ignacio82/grav-mass/bom/bom.csv

section | id | qty | sku | name | vendor | url | alt_skus | spec | where_used | category | optional | notes
electronics | psu-12v-5a | 1 | B01D8FLSV8 | BTF-LIGHTING Regulated `12V DC 5A (60W)` Power Supply Adapter | Amazon | https://www.amazon.com/dp/B01D8FLSV8 |  | `100–240V AC` in → Regulated `12.0V DC, 5.0A (60W)` out, `5.5 × 2.1 mm` center-positive plug, AC wall cord included | Single external power cord plugging into the rear `-X` `5.5 × 2.1 mm` DC barrel jack on [`trunk_base`](../cad/trunk.py) (`26.5W` max simultaneous peak load) | power | false | status: **Required *(New — Single External Supply)*** | link_text: Amazon — BTF-LIGHTING `12V 5A 60W` Power Supply Adapter (`B01D8FLSV8`)
electronics | dc-barrel-jack | 1 | B07C7VSRBG | Pre-Wired `5.5 × 2.1 mm` Threaded Panel-Mount DC Barrel Jack (`18 AWG` Leads) | Amazon | https://www.amazon.com/dp/B07C7VSRBG |  | `12–24V DC`, `5A–10A` rated, `M11 × 0.75` (`Ø 11.0 mm`) thread with hex nut & pre-attached `18 AWG` red/black leads | Mounts into the **`Ø 11.4 mm` rear `-X` DC jack port** (`Z = 10.0 mm`) on [`trunk_base`](../cad/trunk.py); pigtails route internally into the Hollow Root Vault | power | false | status: **Required *(New — Panel DC Entry)*** | link_text: Amazon — 5.5 × 2.1 mm Threaded Panel-Mount DC Barrel Jack with Pre-Wired 18 AWG Leads (`B07C7VSRBG`)
electronics | buck-12v-to-5v | 1 | B07XXWQ49N | UCTRONICS `DC 9V–36V to 5.0V 5A (25W)` Buck Converter Module with Screw Terminals (`U6223`) | Amazon | https://www.amazon.com/UCTRONICS-Converter-Transformer-Voltage-Regulator/dp/B07XXWQ49N | U6223 | `9–36V DC` in → Fixed **`5.0V DC, 5.0A (25W)`** out (`63.0 × 27.0 × 10.0 mm`) with onboard `VIN+/GND` and `OUT+/GND` screw terminals | Seats into the dedicated `+Y` snap-in cradle (`64.2 × 28.2 × 12.0 mm`) inside the `Ø 135 × 50 mm` Hollow Root Vault on Branch 2 (`F2 = 3A` fuse) to power all 66 WS2812B LEDs without loading `C008`'s USB diode | power | false | status: **Required *(New — 5V LED Rail)*** | link_text: Amazon — UCTRONICS `DC 9V–36V to 5V 5A` Screw-Terminal Buck Converter (`B07XXWQ49N`)
electronics | wago-221-pack | 1 | B07NKT2P2F | WAGO `221` Lever-Nut 15-Piece Assortment Pocket Pack (`221-412`, `221-413`, `221-415`) | Amazon | https://www.amazon.com/dp/B07NKT2P2F | 221-412;221-413;221-415 | Includes `5× 221-415` (5-port, `30.0 × 18.6 × 8.4 mm`), `5× 221-413` (3-port, `18.7 × 18.6 × 8.4 mm`), and `5× 221-412` (2-port, `13.1 × 18.6 × 8.4 mm`) lever connectors (`24–12 AWG`) | Uses `2× 221-415` (`WAGO-1 +12V` & `WAGO-2 Star GND`, seated in the `+X` `19.8 × 31.2 × 18.0 mm` organizer cradle) + `2× 221-413` (`WAGO-3 +5V LED` & `WAGO-4 LED GND`) for 100% tool-free distribution | power-distribution | false | qty_display: **1× Pack** | status: **Required *(New — Solder-Free Bus)*** | link_text: Amazon — WAGO `221` Lever-Nut 15-Piece Assortment Pocket Pack (`B07NKT2P2F`)
electronics | inline-blade-fuses | 1 | B087BT1PH3 | Bst4U 6-Pack Inline Blade Fuse Holders + 100-Piece Blade Fuse Assortment Kit (`2A, 3A, 5A` Included) | Amazon | https://www.amazon.com/dp/B087BT1PH3 |  | `6×` pre-wired inline blade fuse holders with protective caps + `100×` blade fuses (`2A, 3A, 5A, 7.5A, 10A, 15A, 20A, 25A, 30A, 35A`) | Uses `3×` inline fuse holders inside the Hollow Root Vault: **`F0 = 5A`** (main `12V` input), **`F1 = 2A`** (`A092` controller/motor), and **`F2 = 3A`** (`5V` LED buck) | protection | false | qty_display: **1× Kit** | status: **Required *(New — Branch Fuses)*** | link_text: Amazon — Bst4U 6-Pack Inline Blade Fuse Holders + 100pc Fuse Kit (`B087BT1PH3`)
electronics | bulk-cap-1000uf | 1 | B07WPWFSNQ | BOJACK `1000 µF 16V` `105 °C` Radial Electrolytic Capacitors (10-Pack) | Amazon | https://www.amazon.com/dp/B07WPWFSNQ |  | `1000 µF`, `16V DC`, `105 °C` low-ESR radial aluminum electrolytic capacitor (`Ø 10 × 17 mm`) | **1×** capacitor has its `+` and `-` leads clamped directly into the `OUT+` and `GND` screw terminals of the `B07XXWQ49N` `5V` buck converter | power | false | qty_display: **1× Pack** | status: **Required *(New — 5V Bulk Cap)*** | link_text: Amazon — BOJACK `1000 µF 16V 105°C` Radial Electrolytic Capacitors (`B07WPWFSNQ`)
electronics | m5stack-hdriver-base | 1 | A092 | M5Stack Atomic H-Bridge Driver Base (`DRV8876`) | M5Stack Store | https://shop.m5stack.com/products/atomic-h-bridge-driver-base-drv8876 |  | `48.0 × 24.0 × 18.0 mm`, **`9–24V DC` input**, TI `DRV8876` H-Bridge (`1.5A` cont / `2.0A` peak), internal `MP1584EN` `12V→5V` buck for `C008`, `HT3.96-4P` screw terminals (`M1`, `M2`, `VIN`, `GND`) | Seats into the stepped `-Y` bottom ESPHome bay (`49.2 × 25.2 × 20.3 mm`) of [`trunk_base`](../cad/trunk.py); powered by **`12.0V DC`** on `VIN`/`GND` via Fuse `F1 (2A)` | controller | false | status: **Existing *(Retained)*** | link_text: M5Stack Store — Atomic H-Bridge Driver Base (`A092`)
electronics | m5stack-atom-lite | 1 | C008 | M5Stack ATOM Lite ESP32 Development Kit | M5Stack Store | https://shop.m5stack.com/products/atom-lite-esp32-development-kit |  | `24.0 × 24.0 × 9.5 mm` `ESP32-PICO-D4` Wi-Fi/BLE controller with `HY2.0-4P` Grove port, `SK6812` RGB LED & button | Snaps onto `A092` (powered internally from `A092`'s `12V→5V` regulator; USB-C needed only for initial flashing of [`esphome/grav-mass-tree.yaml`](../esphome/grav-mass-tree.yaml)) | controller | false | status: **Existing *(Retained)*** | link_text: M5Stack Store — ATOM Lite ESP32 (`C008`)
electronics | m5stack-grove2dupont | 1 | A096 | M5Stack Grove2Dupont Conversion Cable (`20 cm, 5 Pairs`) | M5Stack Store | https://shop.m5stack.com/products/grove2dupont-conversion-cable-20cm-5pairs |  | Male `HY2.0-4P` Grove plug to 4× 2.54 mm DuPont pins (`Black=GND`, `White=G26`, `Yellow=G32`, `Red=+5V` capped/isolated) | Plugs into `C008` Grove port to carry **`White = GPIO26` Track Data**, **`Yellow = GPIO32` Topper Data**, and **`Black = Signal GND`** (`Red +5V` is capped to prevent backfeeding!) | wiring | false | status: **Existing *(Retained)*** | link_text: M5Stack Store — Grove2Dupont Conversion Cable (`A096`)
electronics | motor-n20-12v-150rpm | 1 | B0BFRPMSW6 | `12V DC 150 RPM N20` Micro Metal Gear Motor (`Ø 3.0 mm` D-Shaft) | Amazon | https://www.amazon.com/dp/B0BFRPMSW6 | LA002 | `10 × 12 × 25 mm` metal gearbox (100% identical size to `LA002`), **`12.0V DC` rated**, `150 RPM`, `0.90 kg·cm` torque, `Ø 3.0 mm` D-shaft | Drops directly into [`trunk_base`](../cad/trunk.py) & [`Servo_Or_030_Adapter`](../cad/auger.py) and clamps straight into `A092` **`M1` & `M2`** (`12V` native PWM)! | motor | false | status: **Required *(New — 12V Auger Motor)*** | link_text: Amazon — `12V DC 150 RPM N20` Micro Metal Gear Motor, `Ø 3mm` D-Shaft (`B0BFRPMSW6`)
electronics | led-track-pebble-ws2812b | 1 | B0CCS11V7H | BTF-LIGHTING `DC5V` Addressable `WS2812B` RGB Pebble / Seed Pixel Flexible Wire (`16.4ft / 50 LEDs`, Track) | Amazon | https://www.amazon.com/dp/B0CCS11V7H |  | `360°`-flexible 3-wire cord with `50×` `6.2 × 3.2 mm` oval epoxy RGB LED drops (`5V`, `5W` nominal / `9W` max white), 3-pin `JST-SM` + start/end power-injection leads | Snaps into the **`8.0 × 3.6 mm` dovetail channel (`4.6 mm` throat)** under [`track_seg_01`](../cad/track.py)..[`14`](../cad/track.py); powered from `5V` Buck (`WAGO-3/4`), Data from **`GPIO26` (White)** | lighting-wired | false | status: **Existing *(Retained)*** | link_text: Amazon — BTF-LIGHTING `DC5V` `WS2812B` Pebble/Seed Pixel Flexible Wire (`B0CCS11V7H`)
electronics | led-topper-ring-ws2812 | 1 | B09YTMNGTD | Sparkleiot 16-Bit WS2812 RGB LED Ring with `SM2.54-3P` Wire (Apple Topper) | Amazon | https://www.amazon.com/dp/B09YTMNGTD |  | `Ø 45.0 mm` OD × `Ø 32.0 mm` ID addressable 16-LED 5V RGB ring (`4.8W` max white) with pre-wired 3-pin `JST-SM` (`SM2.54-3P`) plug | Seats flat in the **`Ø 46.2 × 2.5 mm` top rim recess** of [`trunk_top`](../cad/trunk.py) (`Z = 447.5 mm`) inside [`golden_apple_topper`](../cad/topper_planets.py); powered from `5V` Buck, Data from **`GPIO32` (Yellow)** | lighting-wired | false | status: **Existing *(Retained)*** | link_text: Amazon — Sparkleiot 16-Bit WS2812 RGB LED Ring (`B09YTMNGTD`)
electronics | jst-sm-3pin-ext-1m | 1 | B0CT827QQC | 3-Pin `JST-SM` (`SM2.54-3P`) Male-to-Female Extension Cable (`1 m`) | Amazon | https://www.amazon.com/dp/B0CT827QQC |  | 3-pin `JST-SM` plug-and-play extension wire (`5V`, `GND`, `DATA`) | Plugs into the Sparkleiot Topper Ring (`zero soldering`), threads down the **`10 × 8 mm` rear `-X` trunk conduit**, and connects to `WAGO-3/4` (`5V`/`GND`) + **`GPIO32` (Yellow)** | wiring | false | status: **Existing *(Retained)*** | link_text: Amazon — BTF-LIGHTING 3-Pin JST-SM Extension Cable (`B0CT827QQC`)
electronics | led-marble-y-shape | 6 | KC013 | Bambu Lab Y-Shape LED Light with Magnetic Control Switch — Warm White (6 Rolling Apple Marbles) | Bambu Lab Store | https://us.store.bambulab.com/products/y-shape-led-light-with-magnetic-control-switch | KC012 | `Ø 18.0 × 6.5 mm` 3-LED Y-board (`CR1632` battery + `Ø 8 × 2 mm` magnet included) | **6×** drop into the **`Ø 18.70 × 7.30 mm`** equatorial chamber of the 6 Quarter-Turn Bayonet Twist-Lock Marbles (`Apple_Hemisphere_A` + `B`) | lighting-wireless | false | status: **Existing *(Retained)*** | link_text: Bambu Lab Store — Y-Shape LED Light with Magnetic Control Switch (`KC013`)
electronics | led-planet-single | 8 | KA006 | Bambu Lab Single LED Magnetic Control Switch Light (8 Solar System Planets) | Bambu Lab Store | https://us.store.bambulab.com/products/single-led-magnetic-control-switch-light |  | `Ø 7.5 × 6.0 mm` single-LED (`CR927` battery + `Ø 8 × 2 mm` magnet included) | **8×** press-fit into the `Ø 8.0 × 10.0 mm` bottom bores of the 8 Solar System planets (`planet_mercury..neptune`); **1×** magnet presses into [`Magic_LED_Wand`](../cad/topper_planets.py) | lighting-wireless | false | status: **Existing *(Retained)*** | link_text: Bambu Lab Store — Single LED Magnetic Control Switch Light (`KA006`)
electronics | m5stack-ina226-sensor | 1 | U190 | M5Stack Unit `INA226-10A` High-Precision Current/Voltage/Power Sensor | M5Stack Store | https://shop.m5stack.com/products/ina226-voltage-and-current-measurement-unit-10a |  | `32.0 × 24.0 × 10.2 mm`, `0–30V DC`, `±10A`, `HT3.96-4P` screw terminals + Grove `HY2.0-4P` I2C (`0x41`) | Clamps inline with the `5V` LED buck output (`GPIO21`/`GPIO25` I2C header) for real hardware current/power measurement in ESPHome | telemetry | true | qty_display: *Optional* | status: *Optional Telemetry* | link_text: M5Stack Store — Unit `INA226-10A` (`U190`)
electronics | coin-cell-cr1632 | 1 | B07V5CW1MG | LiCB `CR1632` 3V Lithium Coin Cell Batteries (5-Pack) | Amazon | https://www.amazon.com/dp/B07V5CW1MG | CR1632 | `CR1632` (`Ø 16.0 × 3.2 mm`, `3V`) for `KC013` Y-Shape Marble LEDs | Spare coin-cell batteries for the 6 wireless glowing marbles (`KC013`) | battery | true | qty_display: *Optional* | status: *Spare Marble Cells* | link_text: Amazon — LiCB `CR1632` 3V Lithium Coin Cells, 5-Pack (`B07V5CW1MG`)
electronics | coin-cell-cr927 | 1 | B0CMCFGXSL | Tenergy `CR927` 3V Lithium Button Cell Batteries | Amazon | https://www.amazon.com/dp/B0CMCFGXSL | CR927 | `CR927` (`Ø 9.5 × 2.7 mm`, `3V`) for `KA006` Planet LEDs | Spare coin-cell batteries for the 8 wireless Solar System planets (`KA006`) | battery | true | qty_display: *Optional* | status: *Spare Planet Cells* | link_text: Amazon — Tenergy `CR927` 3V Lithium Button Cells (`B0CMCFGXSL`)
fasteners | screw-m25x6-bhcs | 2 | B0BYF4X65F | MonsterBolts `M2.5 × 6 mm` Button Head Cap Machine Screws (BHCS) | Amazon | https://www.amazon.com/dp/B0BYF4X65F |  | `M2.5 × 6 mm` stainless steel button head machine screws | Secures [`Battery_Cover`](../output/Battery_Cover.stl) to the bottom of `trunk_base` | fastener | false | link_text: Amazon — MonsterBolts M2.5 × 6mm Button Head Screws, 50-Pack (`B0BYF4X65F`)
filament | filament-11801 | 2 | 11801 | PLA Matte Dark Brown (`11801`) (#4A2F1D) | Bambu Lab Store | https://us.store.bambulab.com/products/pla-matte |  | ~1150 g (2x 1 kg spools) | **Core Tree `T1`** *(Plates 1–4, 16, 17)* | filament | false
filament | filament-32501 | 2 | 32501 | PETG Translucent Teal (`32501`) (#00A86B) | Bambu Lab Store | https://us.store.bambulab.com/products/petg-translucent |  | ~1080 g (2x 1 kg spools) | **Core Tree `T2`** *(Plates 5–13, 16, 18)* | filament | false
filament | filament-13405 | 1 | 13405 | PLA Silk+ Gold (`13405`) (#D4AF37) | Bambu Lab Store | https://us.store.bambulab.com/products/pla-silk-upgrade |  | ~125 g (1x 1 kg spool) | **Core Tree `T3`** *(Plates 14, 16, 17, 18)* | filament | false
filament | filament-10200 | 1 | 10200 | PLA Basic Red (`10200`) (#C41E3A) | Bambu Lab Store | https://us.store.bambulab.com/products/pla-basic-filament |  | ~155 g (1x 1 kg spool) | **Core Tree `T4`** *(Plates 15, 16, 17)* | filament | false
filament | filament-11100 | 1 | 11100 | PLA Matte Ivory White (`11100`) (#F5EFE6) | Bambu Lab Store | https://us.store.bambulab.com/products/pla-matte |  | ~35 g (1x 1 kg spool) | **Planet Accent** *(Plate 17 `T2` & Plate 18 `T3`)* | filament | false
filament | filament-11600 | 1 | 11600 | PLA Matte Marine Blue (`11600`) (#1E5AA8) | Bambu Lab Store | https://us.store.bambulab.com/products/pla-matte |  | ~30 g (1x 1 kg spool) | **Ocean/Ice Planet Accent** *(Plate 18 `T1`)* | filament | false
