ignacio82/grav-mass/output/3mf/GravMass_Tree_Complete_Assembly.3mf

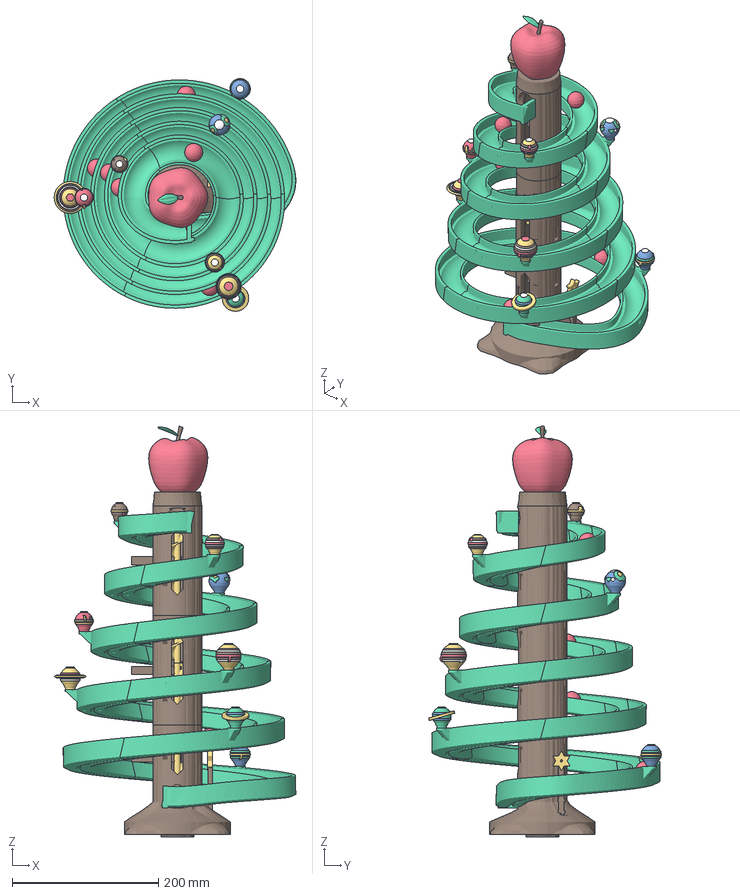
[picture p1: CAD file, 2026-11-08]
output/3mf/GravMass_Tree_Complete_Assembly.3mf
331.0 x 318.8 x 562.8 mm
asm_trunk_base
asm_trunk_mid
asm_trunk_top
asm_Base_Bottom_Cover
asm_Conduit_Cover_Strip_01
asm_Conduit_Cover_Strip_02
asm_Conduit_Cover_Strip_03
asm_auger_lower
asm_auger_upper
asm_track_seg_01
asm_track_seg_02
asm_track_seg_03
asm_track_seg_04
asm_track_seg_05
asm_track_seg_06
asm_track_seg_07
asm_track_seg_08
asm_track_seg_09
asm_track_seg_10
asm_track_seg_11
asm_track_seg_12
asm_track_seg_13
asm_track_seg_14
asm_golden_apple_topper_apple_red_shell
asm_golden_apple_topper_apple_brown_stem
asm_golden_apple_topper_apple_brown_trunk_collar_1
asm_golden_apple_topper_apple_green_leaf
asm_planet_mercury_mercury_basalt_core
asm_planet_mercury_mercury_gold_caloris_basin
asm_planet_mercury_mercury_terracotta_craters_4
asm_planet_mercury_mercury_terracotta_craters_3
asm_planet_mercury_mercury_terracotta_craters_2
asm_planet_mercury_mercury_terracotta_craters_1
asm_planet_mercury_mercury_alabaster_polar_crown
asm_planet_venus_venus_gold_cloud_deck
asm_planet_venus_venus_alabaster_y_waves_3
asm_planet_venus_venus_alabaster_y_waves_2
asm_planet_venus_venus_alabaster_y_waves_1
asm_planet_venus_venus_umber_vortex_collars_2
asm_planet_venus_venus_umber_vortex_collars_1
asm_planet_venus_venus_crimson_superrotation
asm_planet_earth_earth_cobalt_ocean_globe
asm_planet_earth_earth_emerald_continents
asm_planet_earth_earth_gold_mountain_ranges_2
asm_planet_earth_earth_gold_mountain_ranges_1
asm_planet_earth_earth_white_polar_ice_clouds_3
asm_planet_earth_earth_white_polar_ice_clouds_2
asm_planet_earth_earth_white_polar_ice_clouds_1
asm_planet_mars_mars_terracotta_body
asm_planet_mars_mars_ochre_tharsis_hellas
asm_planet_mars_mars_basalt_canyon_olympus_2
asm_planet_mars_mars_basalt_canyon_olympus_1
asm_planet_mars_mars_alabaster_polar_cap
asm_planet_jupiter_jupiter_gold_zones
asm_planet_jupiter_jupiter_alabaster_tropical_zones_2
asm_planet_jupiter_jupiter_alabaster_tropical_zones_1
asm_planet_jupiter_jupiter_umber_temperate_belts_3
asm_planet_jupiter_jupiter_umber_temperate_belts_2
asm_planet_jupiter_jupiter_umber_temperate_belts_1
asm_planet_jupiter_jupiter_crimson_great_red_spot_2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
