ignacio82/grav-mass/output/3mf/Plate_6_SingleColor_Green_Track_02.3mf

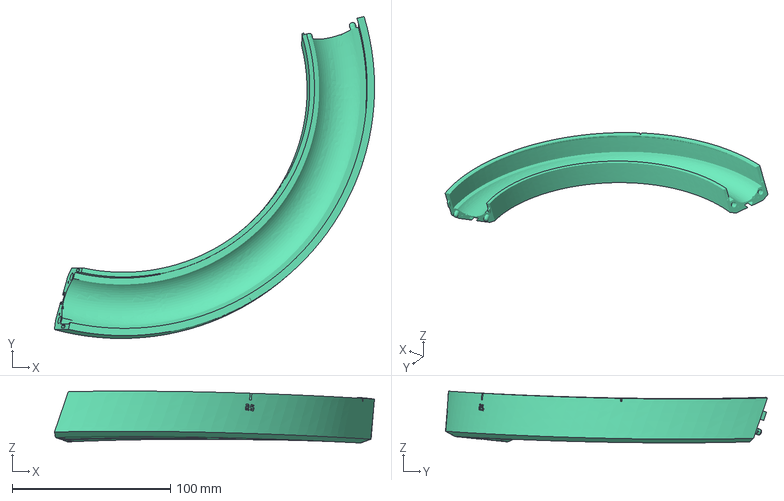
[picture p2: CAD file, 2026-11-08]
output/3mf/Plate_6_SingleColor_Green_Track_02.3mf
202.2 x 203.4 x 32.7 mm
