ignacio82/grav-mass/output/track_seg_13.step

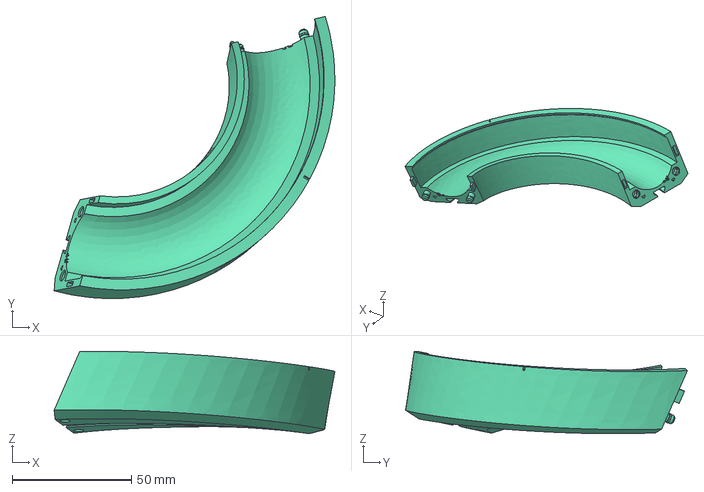
[picture p3: CAD file, 2026-11-08]
output/track_seg_13.step
117.9 x 118.4 x 34.6 mm
