ignacio82/grav-mass/output/3mf/Plate_13_SingleColor_Green_Track_09_And_14.3mf

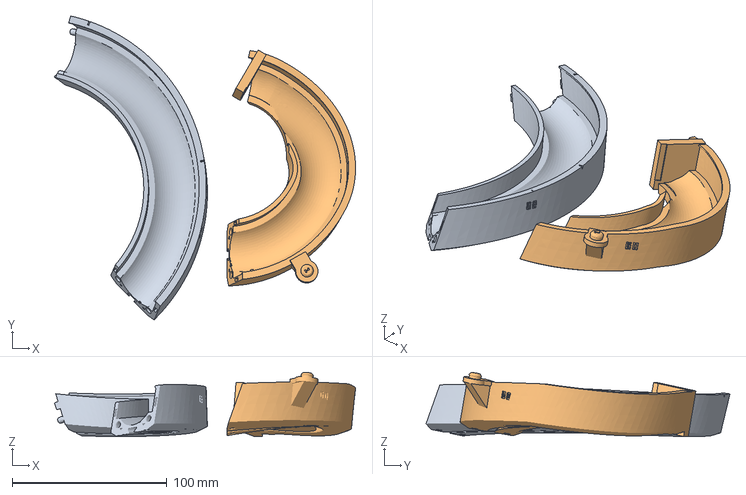
[picture p4: CAD file, 2026-11-08]
output/3mf/Plate_13_SingleColor_Green_Track_09_And_14.3mf
194.5 x 196.3 x 41.4 mm
track_seg_09
track_seg_14_top_entry
