ignacio82/grav-mass/output/bracket_19.step

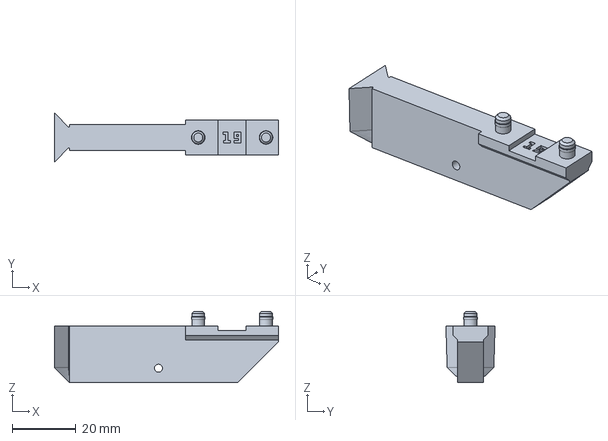
[picture p5: CAD file, 2026-11-08]
output/bracket_19.step
70.0 x 15.4 x 22.2 mm
