ignacio82/grav-mass/output/3mf/Plate_8_SingleColor_Green_Track_04.3mf

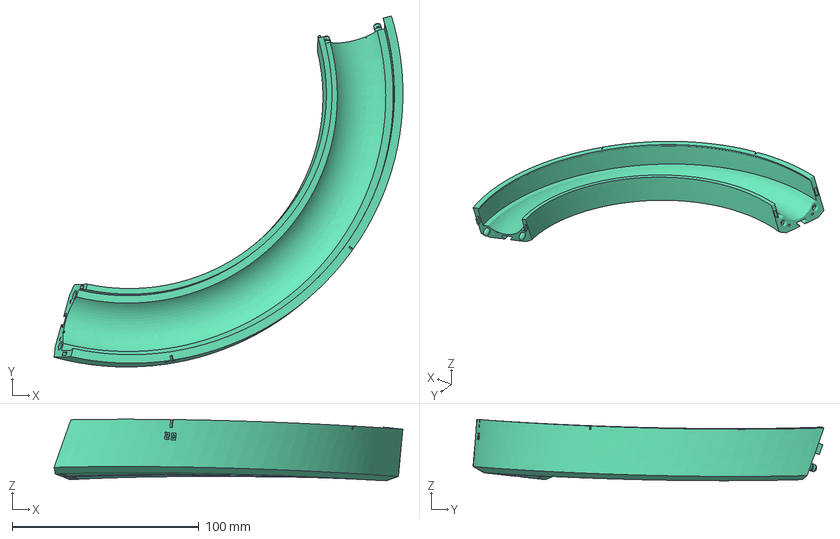
[picture p6: CAD file, 2026-11-08]
output/3mf/Plate_8_SingleColor_Green_Track_04.3mf
186.6 x 187.8 x 32.9 mm
