ignacio82/grav-mass/output/track_seg_12.step

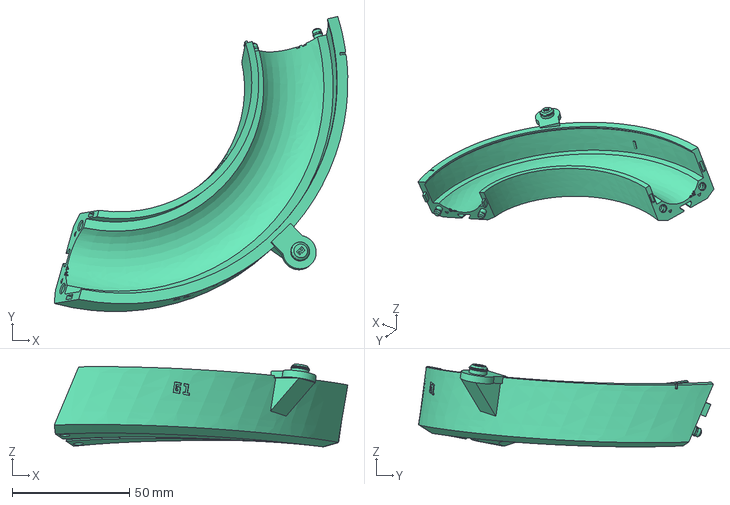
[picture p7: CAD file, 2026-11-08]
output/track_seg_12.step
125.3 x 125.9 x 35.4 mm
