ignacio82/grav-mass/output/planet_jupiter.step

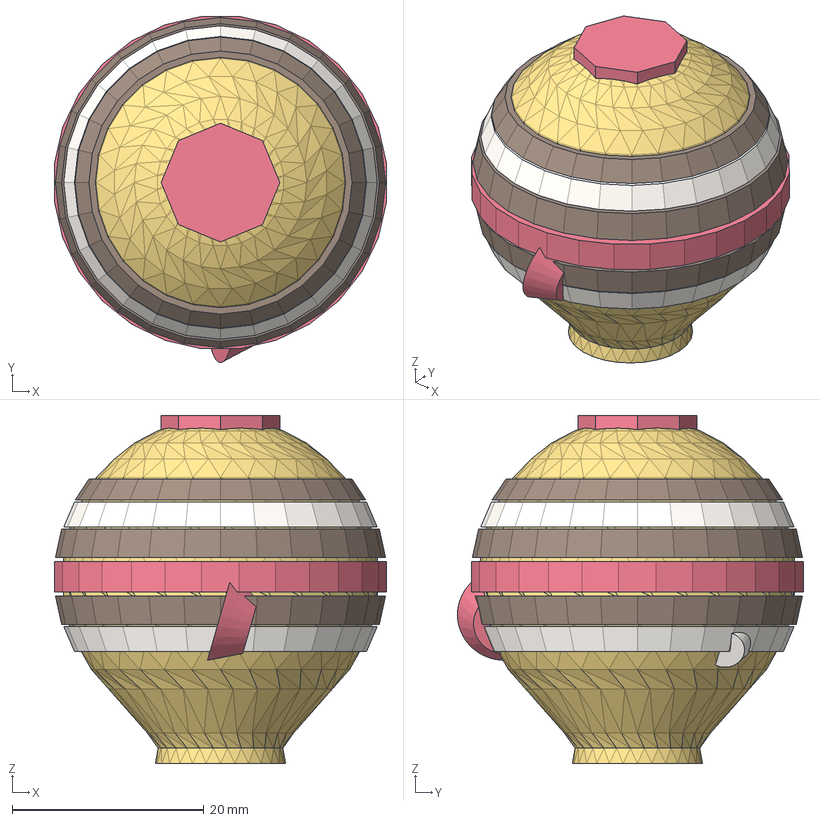
[picture p8: CAD file, 2026-11-08]
output/planet_jupiter.step
34.7 x 36.1 x 36.3 mm
jupiter_gold_zones
jupiter_alabaster_tropical_zones_2
jupiter_alabaster_tropical_zones_1
jupiter_umber_temperate_belts_3
jupiter_umber_temperate_belts_2
jupiter_umber_temperate_belts_1
jupiter_crimson_great_red_spot_2
jupiter_crimson_great_red_spot_1
