ignacio82/grav-mass/output/3mf/Plate_17_MultiColor_Planets_Warm_And_Gas_Giants.3mf

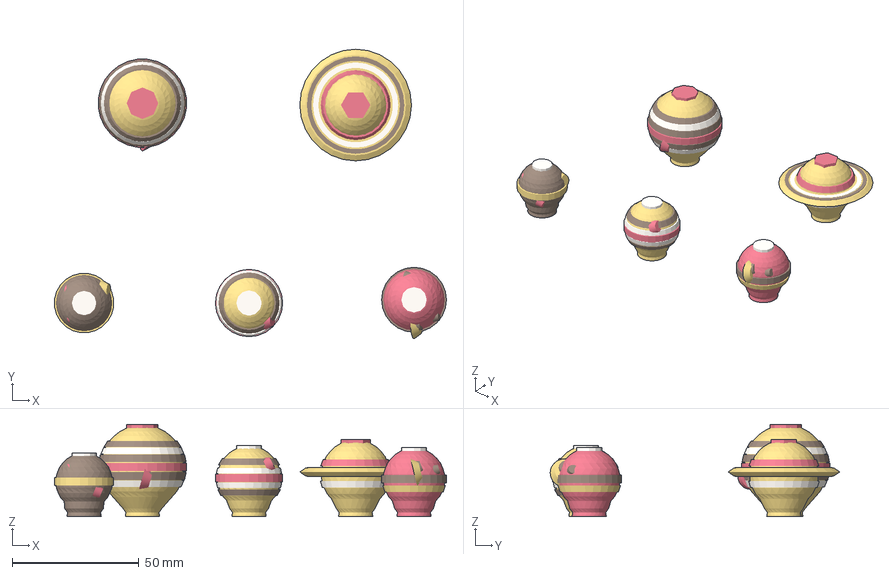
[picture p9: CAD file, 2026-11-08]
output/3mf/Plate_17_MultiColor_Planets_Warm_And_Gas_Giants.3mf
154.4 x 114.1 x 36.3 mm
planet_mercury
planet_venus
planet_mars
planet_jupiter
planet_saturn
