ignacio82/grav-mass/output/Battery_Cover.step

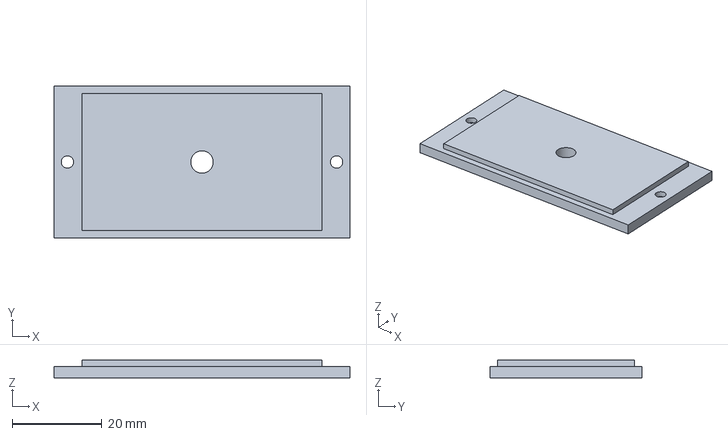
[picture p10: CAD file, 2026-11-08]
output/Battery_Cover.step
66.0 x 34.0 x 4.00 mm
