ignacio82/grav-mass/output/3mf/Plate_7_SingleColor_Green_Track_03.3mf

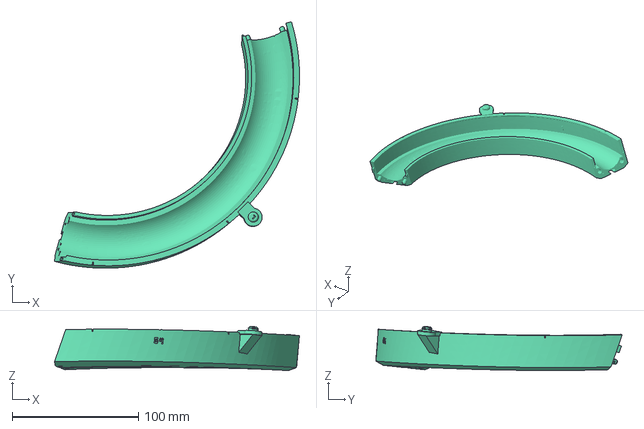
[picture p11: CAD file, 2026-11-08]
output/3mf/Plate_7_SingleColor_Green_Track_03.3mf
194.4 x 195.6 x 34.9 mm
