ignacio82/grav-mass/output/Motor_Clutch_Driver.step

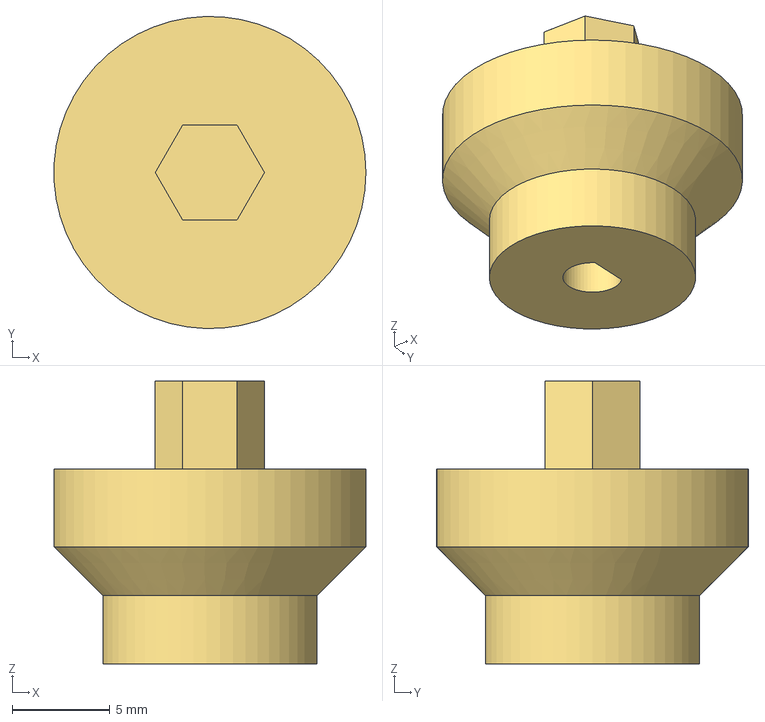
[picture p12: CAD file, 2026-11-08]
output/Motor_Clutch_Driver.step
16.0 x 16.0 x 14.5 mm
