ignacio82/grav-mass/output/3mf/Plate_18_MultiColor_Planets_Ocean_And_Ice_Giants.3mf

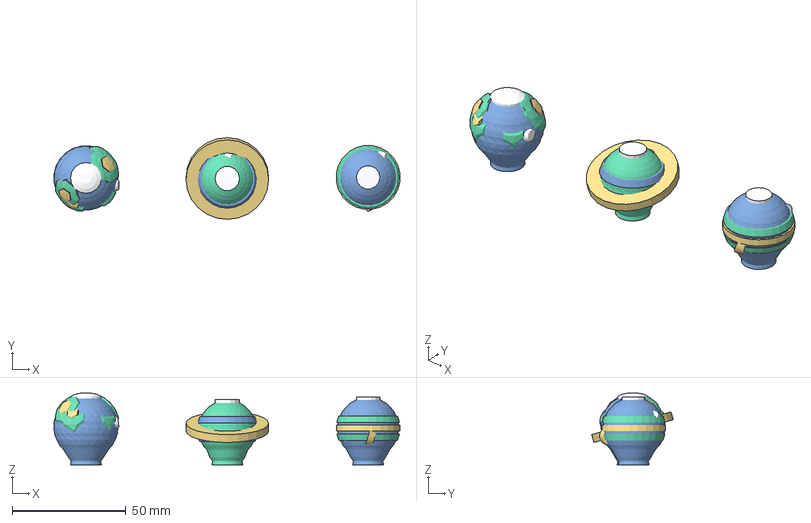
[picture p13: CAD file, 2026-11-08]
output/3mf/Plate_18_MultiColor_Planets_Ocean_And_Ice_Giants.3mf
152.3 x 36.0 x 31.5 mm
planet_earth
planet_uranus
planet_neptune
