ignacio82/grav-mass/output/Magic_LED_Wand.step

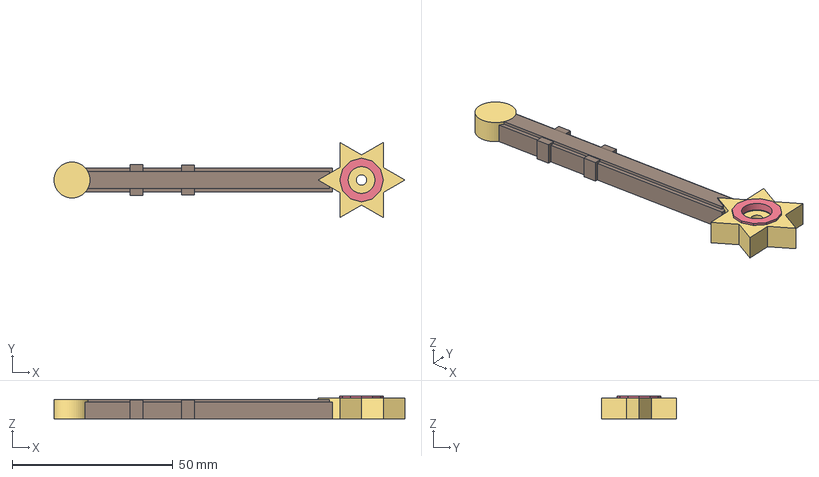
[picture p14: CAD file, 2026-11-08]
output/Magic_LED_Wand.step
109.1 x 23.4 x 7.00 mm
wand_gold_star
wand_gold_pommel_1
wand_brown_shaft
wand_crimson_bezel
