ignacio82/grav-mass/output/3mf/Plate_4_SingleColor_Brown_Brackets_13_To_24.3mf

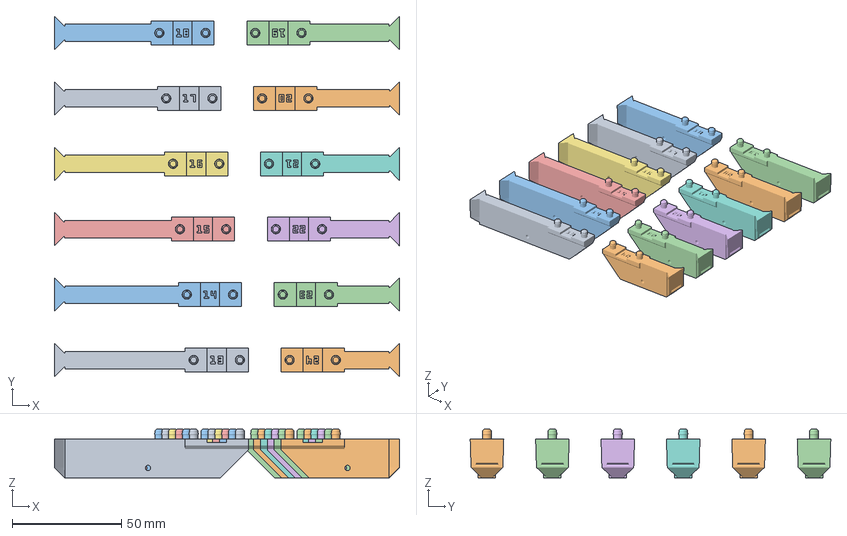
[picture p15: CAD file, 2026-11-08]
output/3mf/Plate_4_SingleColor_Brown_Brackets_13_To_24.3mf
158.2 x 165.4 x 22.2 mm
bracket_13
bracket_24
bracket_14
bracket_23
bracket_15
bracket_22
bracket_16
bracket_21
bracket_17
bracket_20
bracket_18
bracket_19
