ignacio82/grav-mass/output/bracket_22.step

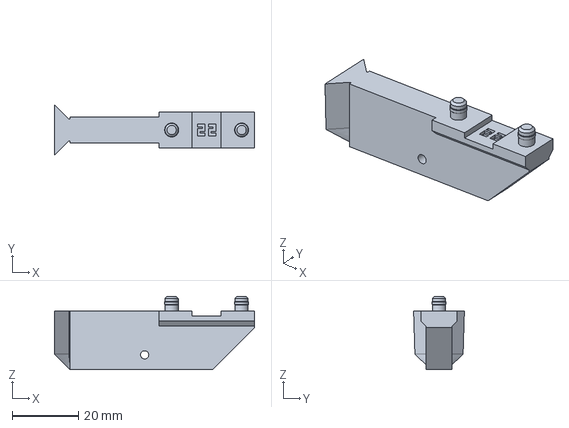
[picture p16: CAD file, 2026-11-08]
output/bracket_22.step
60.6 x 15.4 x 22.2 mm
