ignacio82/grav-mass/output/3mf/GravMass_Tree_Ultimate_U1.3mf

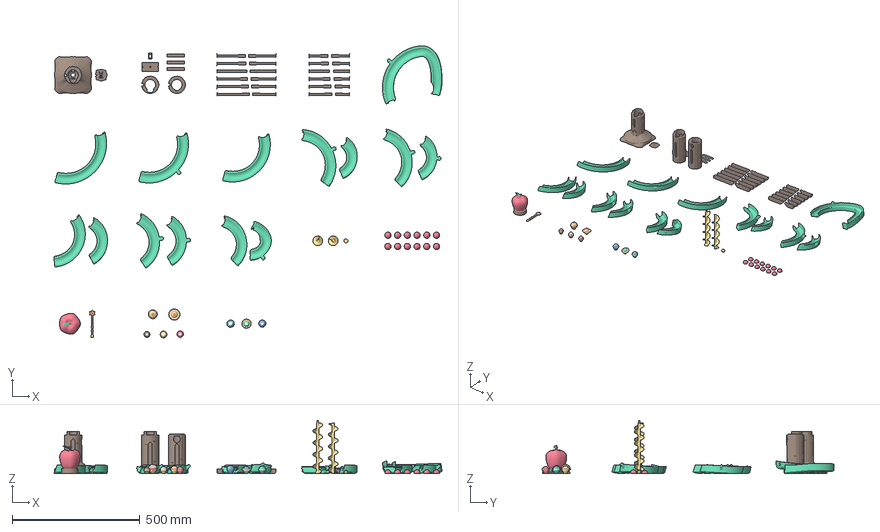
[picture p17: CAD file, 2026-11-08]
output/3mf/GravMass_Tree_Ultimate_U1.3mf
1517.0 x 1142.1 x 208.0 mm
trunk_base
Base_Bottom_Cover
trunk_mid
trunk_top
Battery_Cover
Servo_Or_030_Adapter
Conduit_Cover_Strip_01
Conduit_Cover_Strip_02
Conduit_Cover_Strip_03
bracket_01
bracket_12
bracket_02
bracket_11
bracket_03
bracket_10
bracket_04
bracket_09
bracket_05
bracket_08
bracket_06
bracket_07
bracket_13
bracket_24
bracket_14
bracket_23
bracket_15
bracket_22
bracket_16
bracket_21
bracket_17
bracket_20
bracket_18
bracket_19
track_seg_01
track_seg_02
track_seg_03
track_seg_04
track_seg_05
track_seg_13
track_seg_06
track_seg_12
track_seg_07
track_seg_11
track_seg_08
track_seg_10
track_seg_09
track_seg_14_top_entry
auger_lower
auger_upper
Motor_Clutch_Driver
apple_hemisphere_a_01
apple_hemisphere_a_02
apple_hemisphere_a_03
apple_hemisphere_a_04
apple_hemisphere_a_05
apple_hemisphere_a_06
apple_hemisphere_b_01
apple_hemisphere_b_02
apple_hemisphere_b_03
apple_hemisphere_b_04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
