ignacio82/grav-mass/output/bracket_23.step

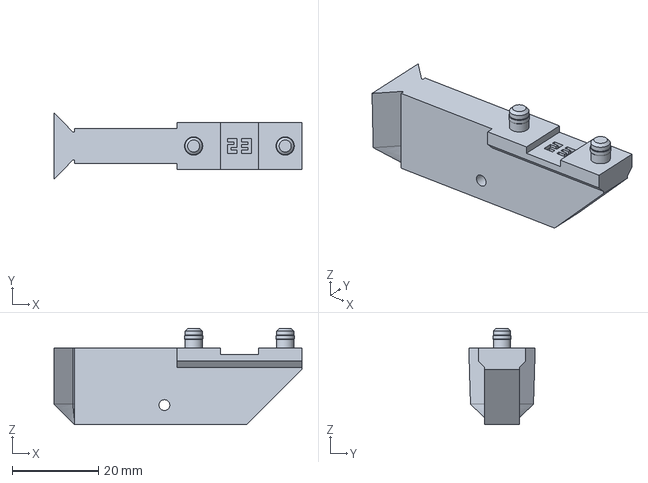
[picture p18: CAD file, 2026-11-08]
output/bracket_23.step
57.4 x 15.4 x 22.2 mm
