ignacio82/grav-mass/output/3mf/Plate_1_SingleColor_Brown_Trunk_Base.3mf

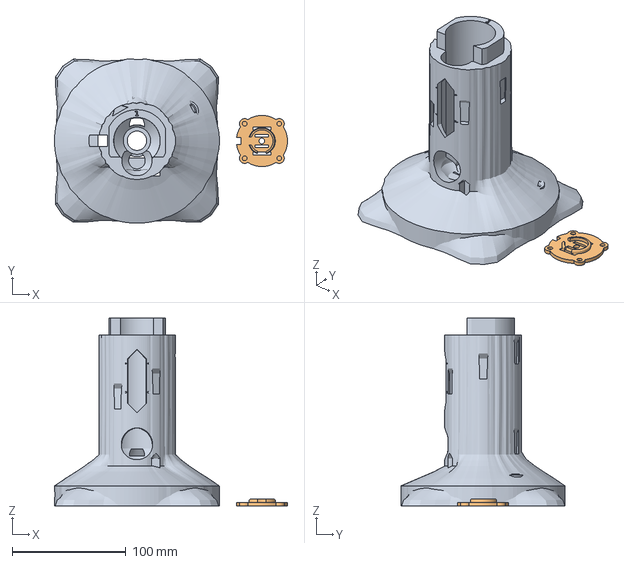
[picture p19: CAD file, 2026-11-08]
output/3mf/Plate_1_SingleColor_Brown_Trunk_Base.3mf
204.9 x 144.5 x 165.0 mm
trunk_base
Base_Bottom_Cover
