ignacio82/grav-mass/output/bracket_15.step

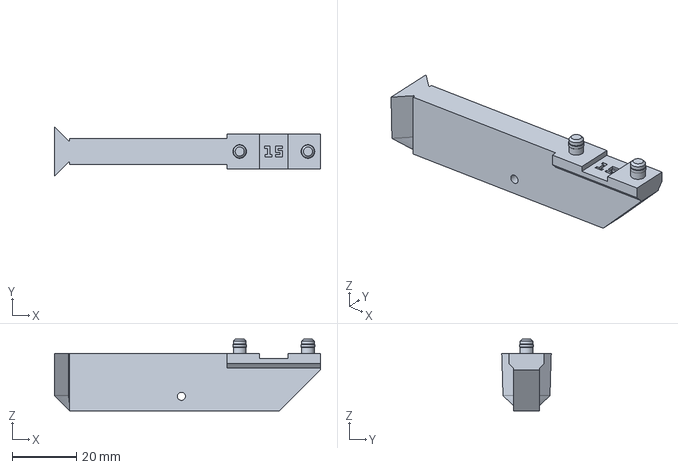
[picture p20: CAD file, 2026-11-08]
output/bracket_15.step
82.6 x 15.4 x 22.2 mm
