ignacio82/grav-mass/output/3mf/Plate_16_MultiColor_Topper_And_Wand.3mf

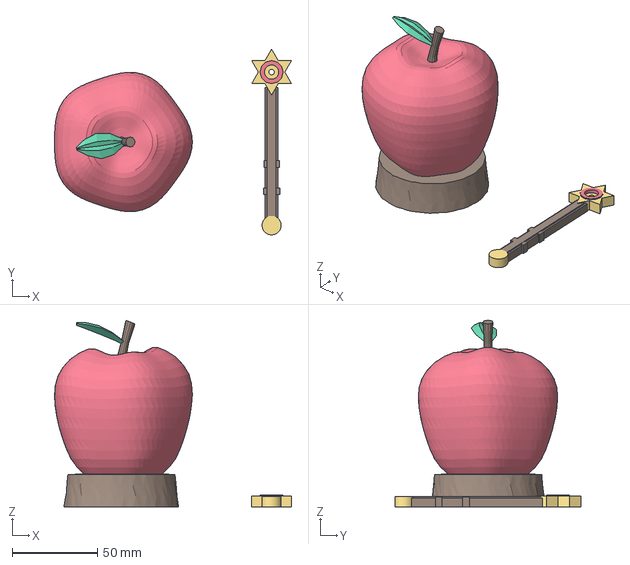
[picture p21: CAD file, 2026-11-08]
output/3mf/Plate_16_MultiColor_Topper_And_Wand.3mf
139.2 x 109.1 x 109.6 mm
golden_apple_topper
Magic_LED_Wand
