ignacio82/grav-mass/output/Base_Bottom_Cover.step

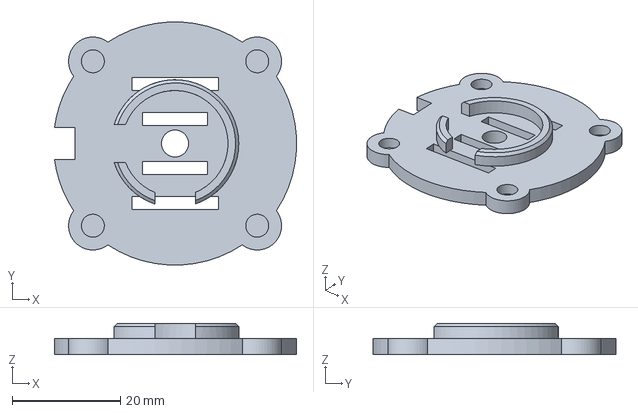
[picture p22: CAD file, 2026-11-08]
output/Base_Bottom_Cover.step
44.8 x 44.9 x 5.80 mm
