ignacio82/grav-mass/output/3mf/Plate_15_SingleColor_Red_Apple_Marbles.3mf

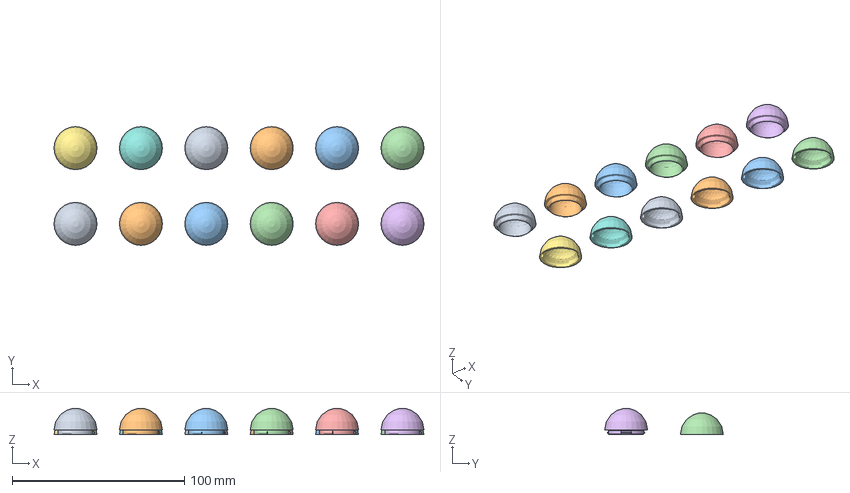
[picture p23: CAD file, 2026-11-08]
output/3mf/Plate_15_SingleColor_Red_Apple_Marbles.3mf
215.0 x 69.0 x 15.2 mm
apple_hemisphere_a_01
apple_hemisphere_a_02
apple_hemisphere_a_03
apple_hemisphere_a_04
apple_hemisphere_a_05
apple_hemisphere_a_06
apple_hemisphere_b_01
apple_hemisphere_b_02
apple_hemisphere_b_03
apple_hemisphere_b_04
apple_hemisphere_b_05
apple_hemisphere_b_06
