ignacio82/grav-mass/output/trunk_top.step

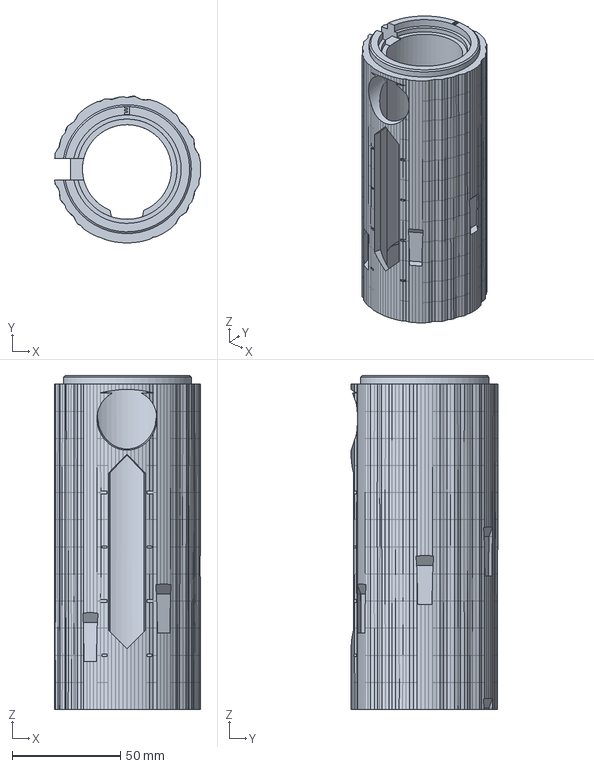
[picture p24: CAD file, 2026-11-08]
output/trunk_top.step
67.5 x 67.7 x 154.0 mm
