ignacio82/grav-mass/output/3mf/Plate_11_SingleColor_Green_Track_07_And_11.3mf

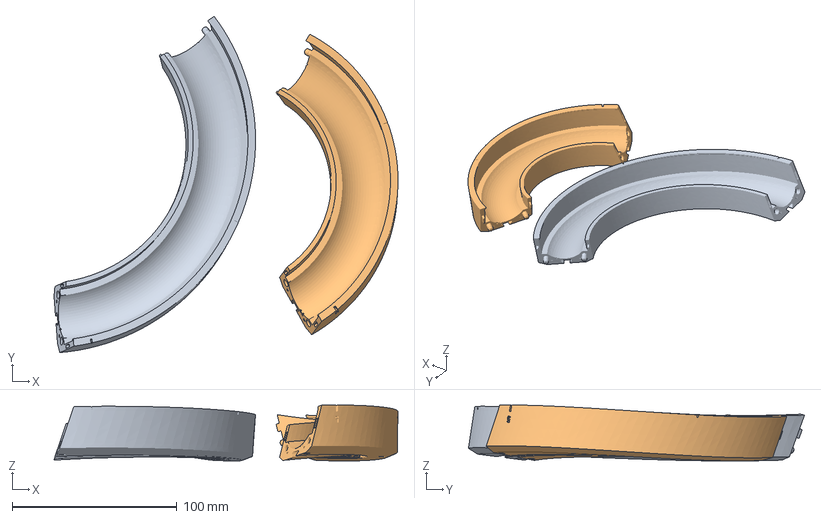
[picture p25: CAD file, 2026-11-08]
output/3mf/Plate_11_SingleColor_Green_Track_07_And_11.3mf
209.0 x 204.3 x 34.0 mm
track_seg_07
track_seg_11
