ignacio82/grav-mass/output/Servo_Or_030_Adapter.step

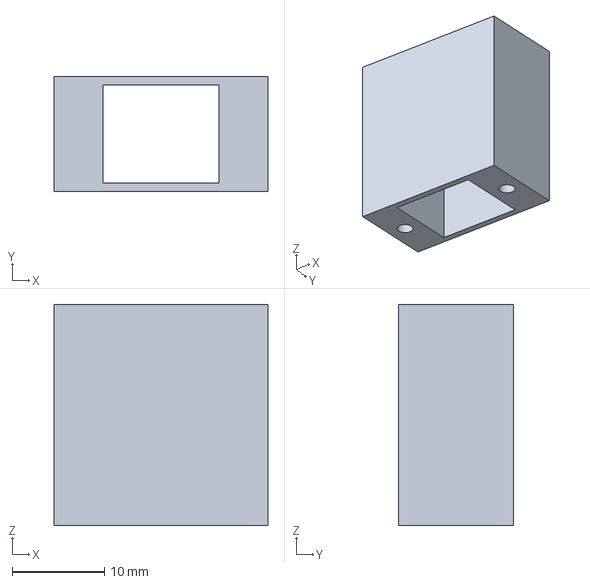
[picture p26: CAD file, 2026-11-08]
output/Servo_Or_030_Adapter.step
23.2 x 12.5 x 24.0 mm
