ignacio82/grav-mass/output/3mf/Plate_5_SingleColor_Green_Track_01.3mf

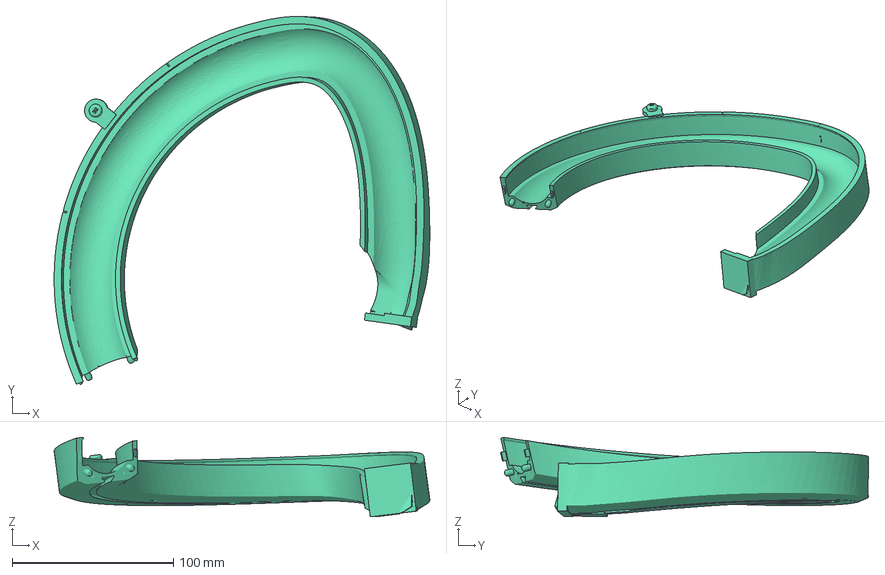
[picture p27: CAD file, 2026-11-08]
output/3mf/Plate_5_SingleColor_Green_Track_01.3mf
232.9 x 228.1 x 49.3 mm
