ignacio82/grav-mass/output/auger_lower.step

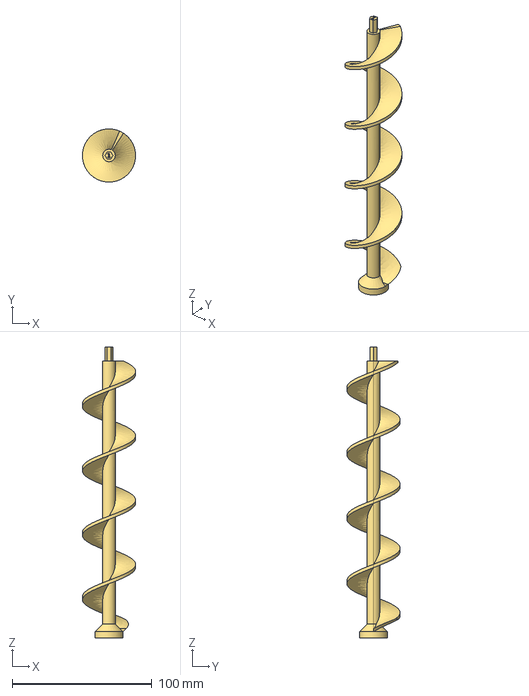
[picture p28: CAD file, 2026-11-08]
output/auger_lower.step
38.0 x 38.0 x 208.0 mm
