ignacio82/grav-mass/output/3mf/Plate_9_SingleColor_Green_Track_05_And_13.3mf

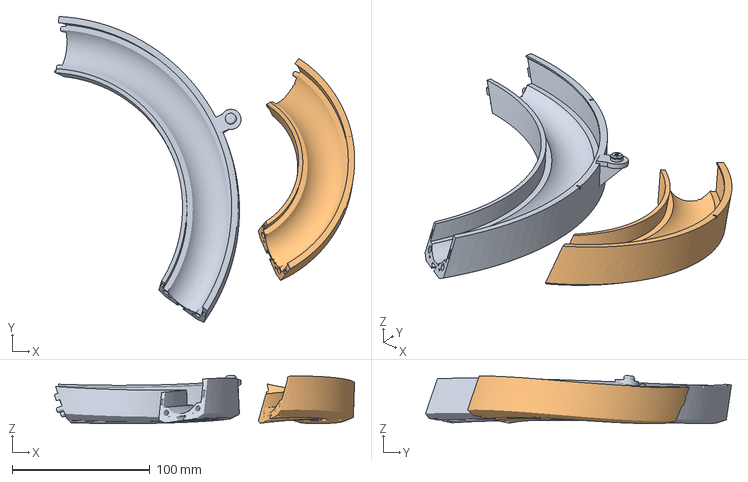
[picture p29: CAD file, 2026-11-08]
output/3mf/Plate_9_SingleColor_Green_Track_05_And_13.3mf
218.3 x 222.4 x 35.0 mm
track_seg_05
track_seg_13
