ignacio82/grav-mass/output/planet_mercury.step

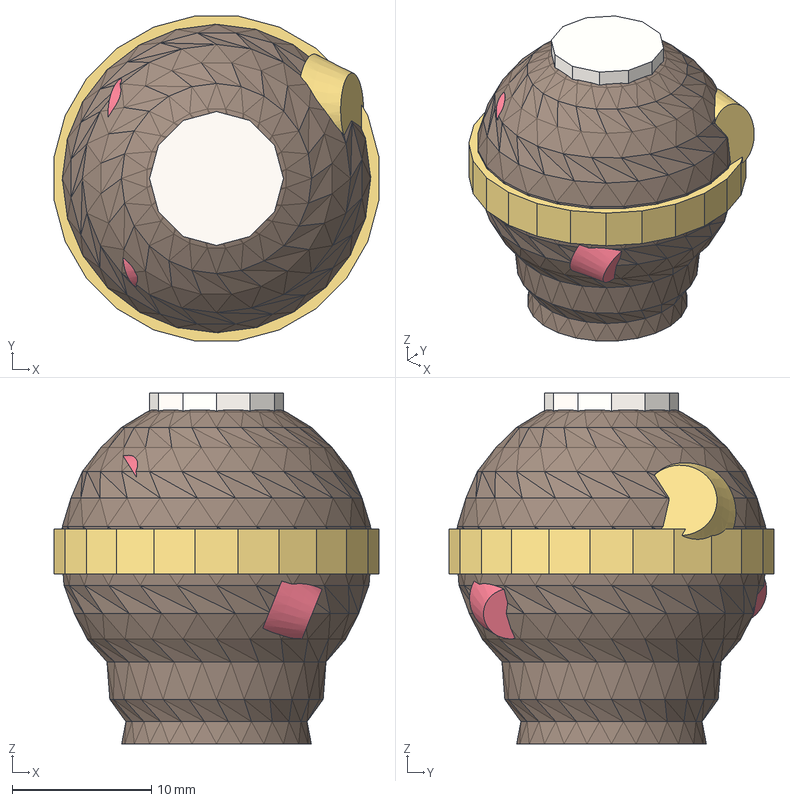
[picture p30: CAD file, 2026-11-08]
output/planet_mercury.step
23.3 x 23.3 x 25.2 mm
mercury_basalt_core
mercury_gold_caloris_basin
mercury_terracotta_craters_4
mercury_terracotta_craters_3
mercury_terracotta_craters_2
mercury_terracotta_craters_1
mercury_alabaster_polar_crown
