ignacio82/grav-mass/output/3mf/Plate_3_SingleColor_Brown_Brackets_01_To_12.3mf

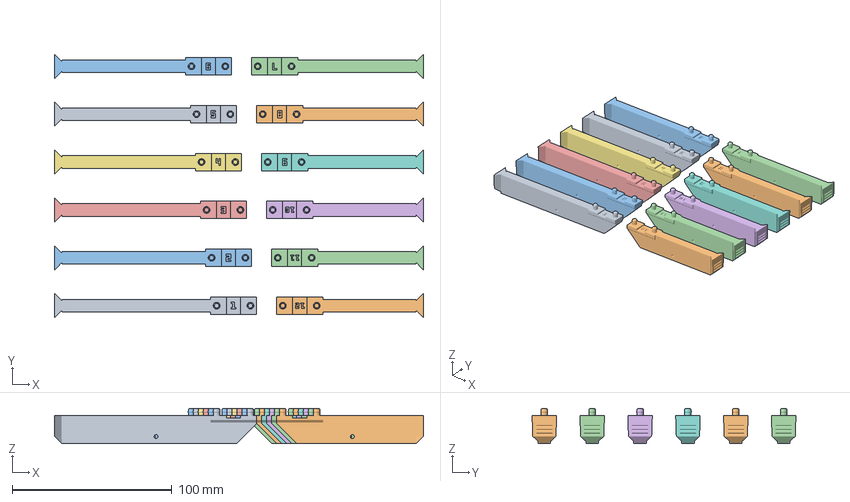
[picture p31: CAD file, 2026-11-08]
output/3mf/Plate_3_SingleColor_Brown_Brackets_01_To_12.3mf
231.3 x 165.4 x 22.2 mm
bracket_01
bracket_12
bracket_02
bracket_11
bracket_03
bracket_10
bracket_04
bracket_09
bracket_05
bracket_08
bracket_06
bracket_07
