ignacio82/grav-mass/output/3mf/Plate_14_SingleColor_Gold_Auger_And_Drive.3mf

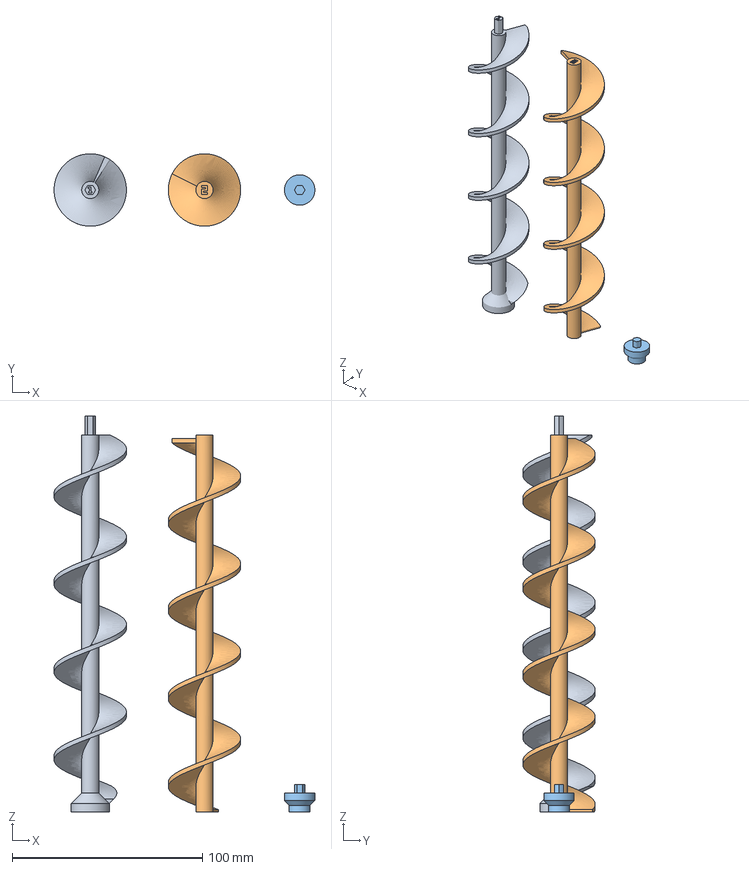
[picture p32: CAD file, 2026-11-08]
output/3mf/Plate_14_SingleColor_Gold_Auger_And_Drive.3mf
137.0 x 38.0 x 208.0 mm
auger_lower
auger_upper
Motor_Clutch_Driver
