ignacio82/grav-mass/output/track_seg_10.step

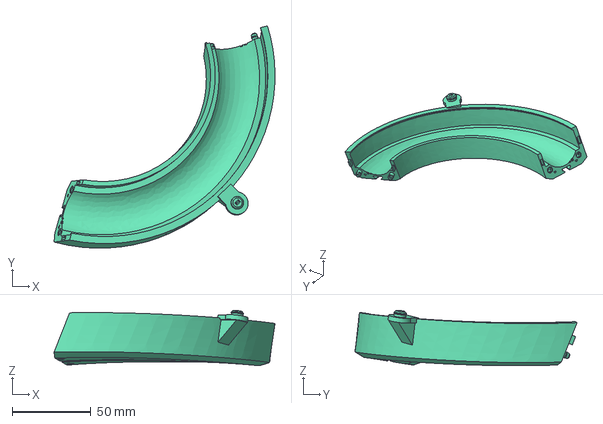
[picture p33: CAD file, 2026-11-08]
output/track_seg_10.step
140.5 x 141.2 x 35.2 mm
