ignacio82/grav-mass/output/3mf/Plate_12_SingleColor_Green_Track_08_And_10.3mf

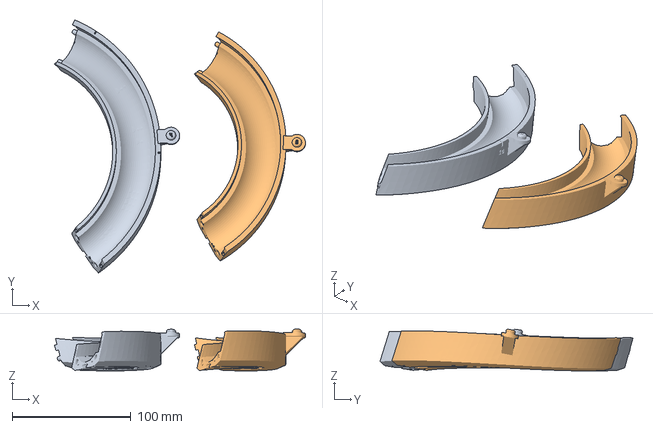
[picture p34: CAD file, 2026-11-08]
output/3mf/Plate_12_SingleColor_Green_Track_08_And_10.3mf
211.5 x 213.2 x 35.2 mm
track_seg_08
track_seg_10
