ignacio82/grav-mass/output/bracket_12.step

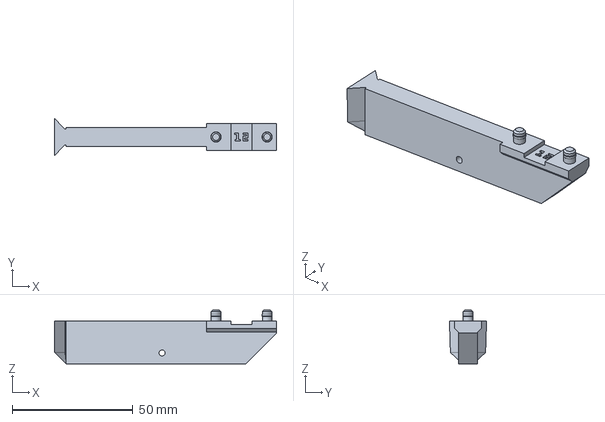
[picture p35: CAD file, 2026-11-08]
output/bracket_12.step
92.1 x 15.4 x 22.2 mm
