ignacio82/grav-mass/output/3mf/Plate_2_SingleColor_Brown_Trunk_Upper_And_Covers.3mf

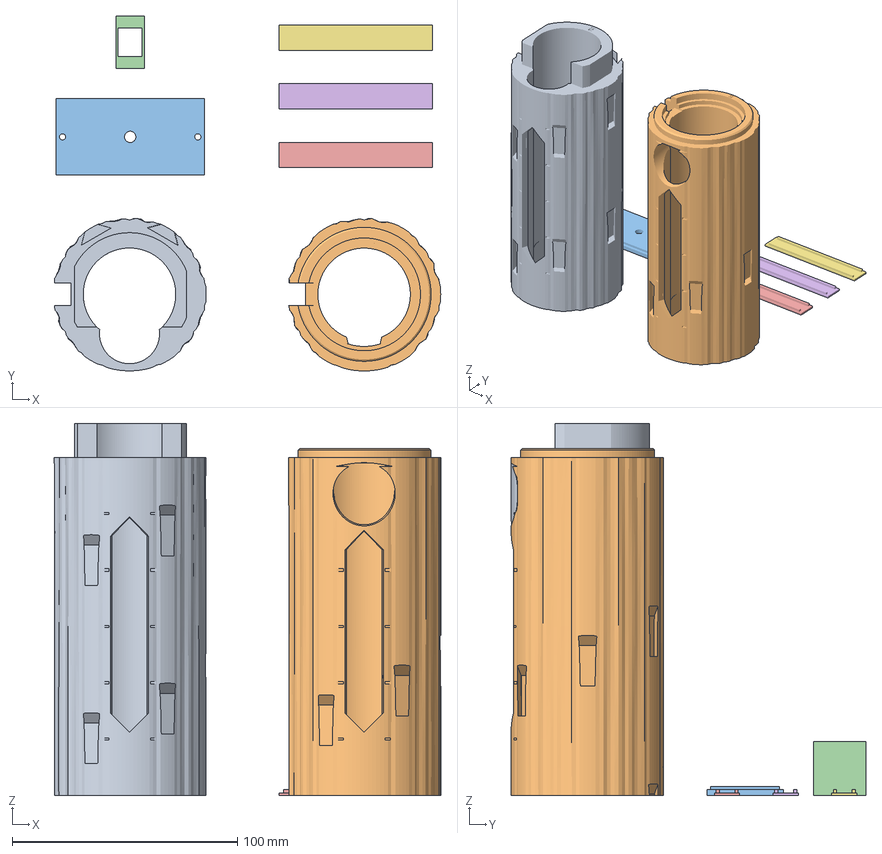
[picture p36: CAD file, 2026-11-08]
output/3mf/Plate_2_SingleColor_Brown_Trunk_Upper_And_Covers.3mf
171.4 x 157.4 x 165.0 mm
trunk_mid
trunk_top
Battery_Cover
Servo_Or_030_Adapter
Conduit_Cover_Strip_01
Conduit_Cover_Strip_02
Conduit_Cover_Strip_03
