ignacio82/grav-mass/output/track_seg_11.step

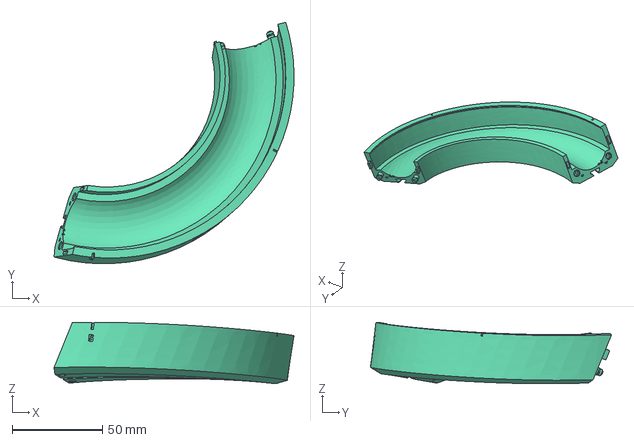
[picture p37: CAD file, 2026-11-08]
output/track_seg_11.step
132.9 x 133.6 x 34.0 mm
