ignacio82/grav-mass/output/3mf/Plate_10_SingleColor_Green_Track_06_And_12.3mf

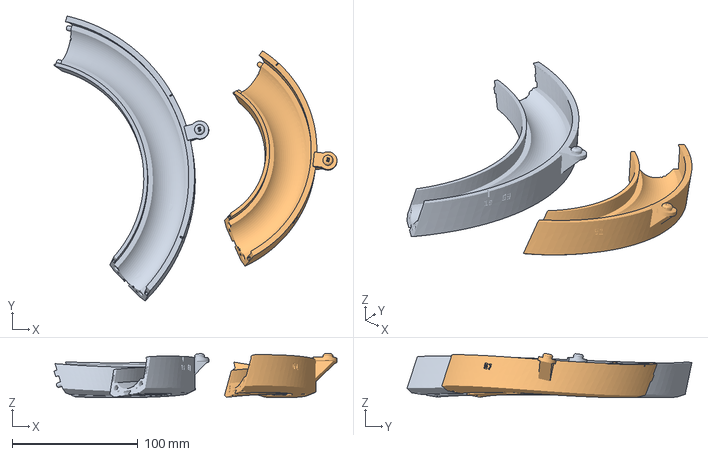
[picture p38: CAD file, 2026-11-08]
output/3mf/Plate_10_SingleColor_Green_Track_06_And_12.3mf
225.5 x 227.0 x 35.4 mm
track_seg_06
track_seg_12
