ignacio82/grav-mass/output/track_seg_05.step

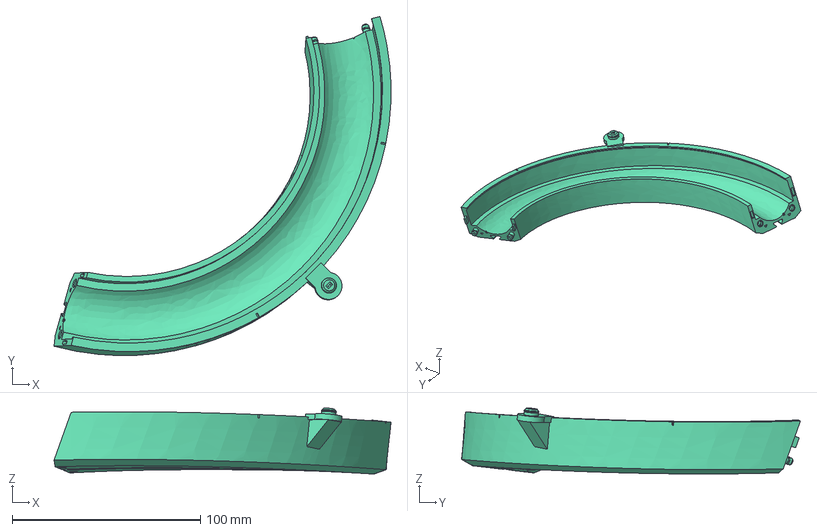
[picture p39: CAD file, 2026-11-08]
output/track_seg_05.step
178.8 x 179.9 x 35.0 mm
