ignacio82/grav-mass/output/Conduit_Cover_Strip.step

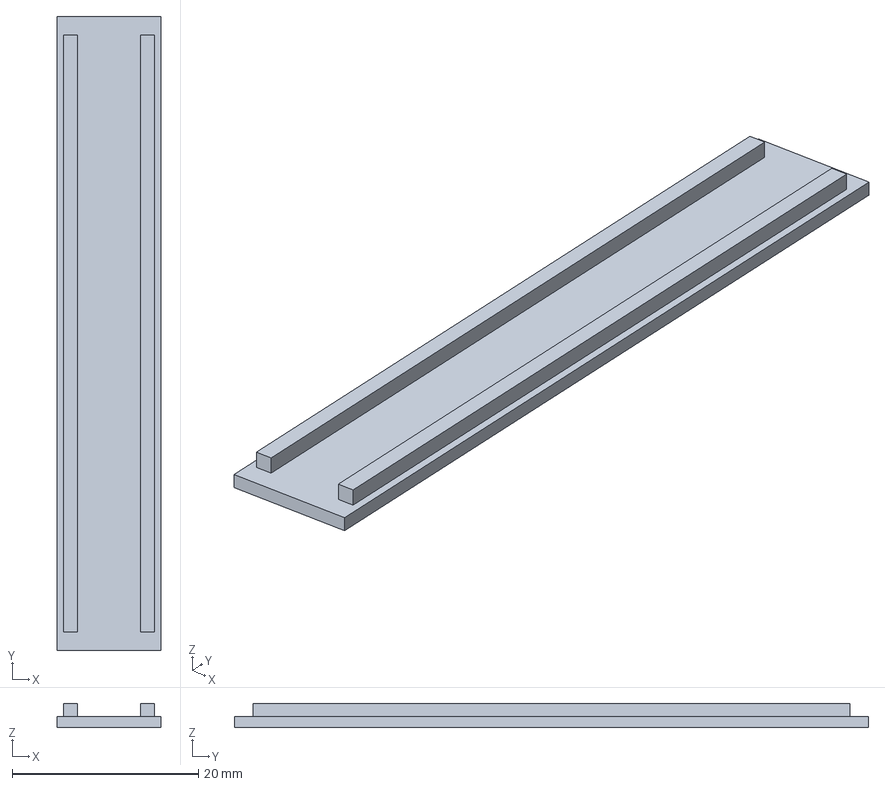
[picture p40: CAD file, 2026-11-08]
output/Conduit_Cover_Strip.step
11.2 x 68.0 x 2.60 mm
