ignacio82/grav-mass/output/bracket_03.step

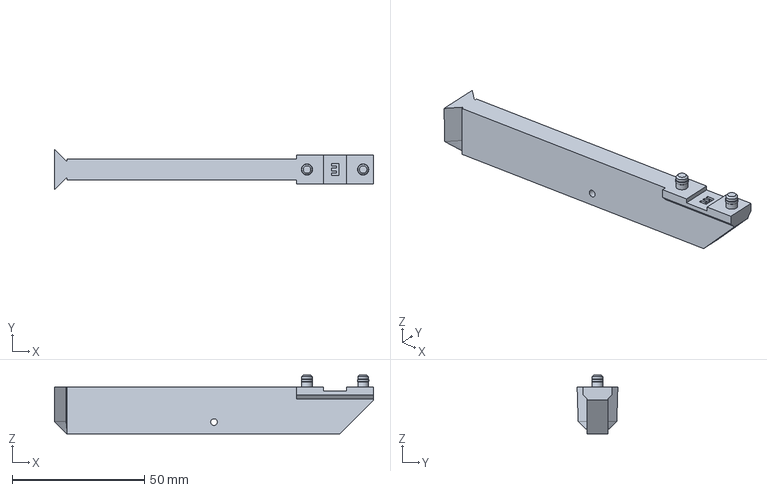
[picture p41: CAD file, 2026-11-08]
output/bracket_03.step
120.4 x 15.4 x 22.2 mm
