ignacio82/grav-mass/output/bracket_20.step

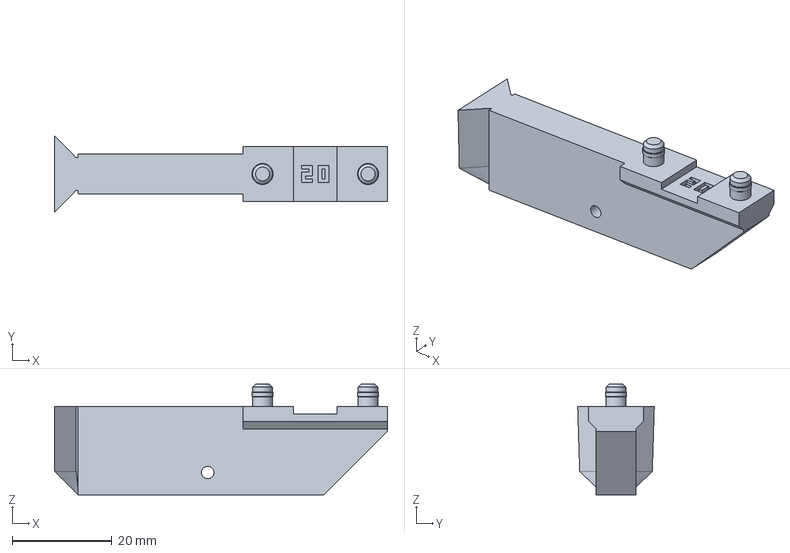
[picture p42: CAD file, 2026-11-08]
output/bracket_20.step
66.9 x 15.4 x 22.2 mm
