ignacio82/grav-mass/output/track_seg_08.step

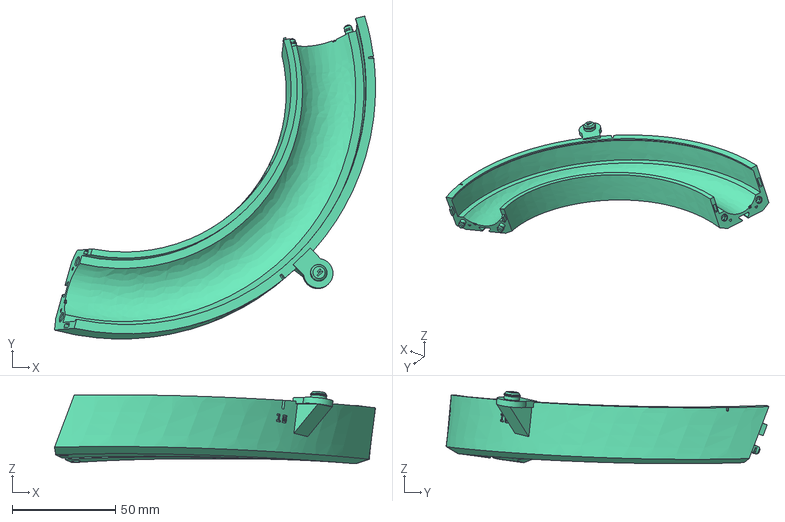
[picture p43: CAD file, 2026-11-08]
output/track_seg_08.step
155.7 x 156.6 x 35.1 mm
