ignacio82/grav-mass/output/planet_saturn.step

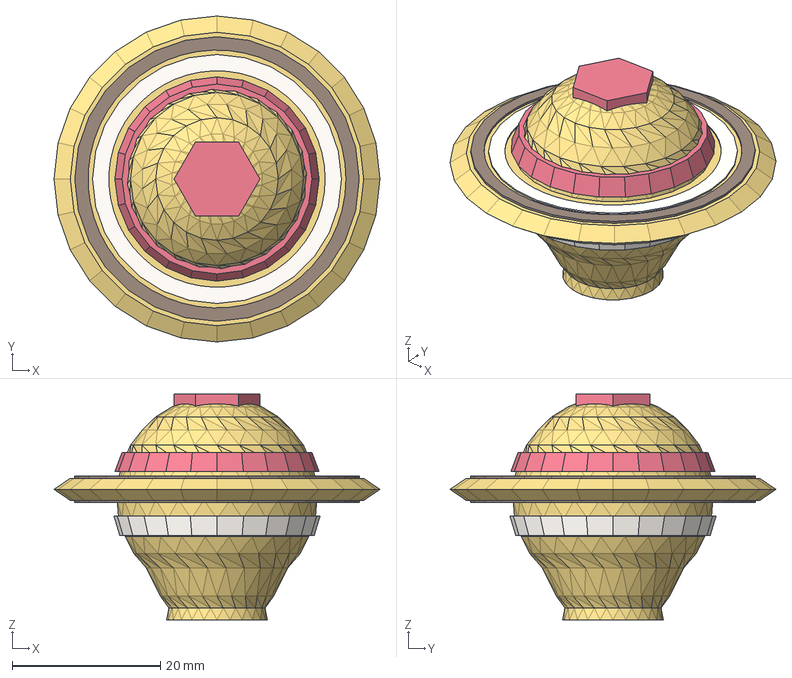
[picture p44: CAD file, 2026-11-08]
output/planet_saturn.step
44.0 x 44.0 x 30.4 mm
saturn_gold_globe_and_ring_3
saturn_gold_globe_and_ring_2
saturn_gold_globe_and_ring_1
saturn_alabaster_inner_ring_2
saturn_alabaster_inner_ring_1
saturn_umber_cassini_division
saturn_crimson_polar_hexagon_2
saturn_crimson_polar_hexagon_1
