ignacio82/grav-mass/output/auger_upper.step

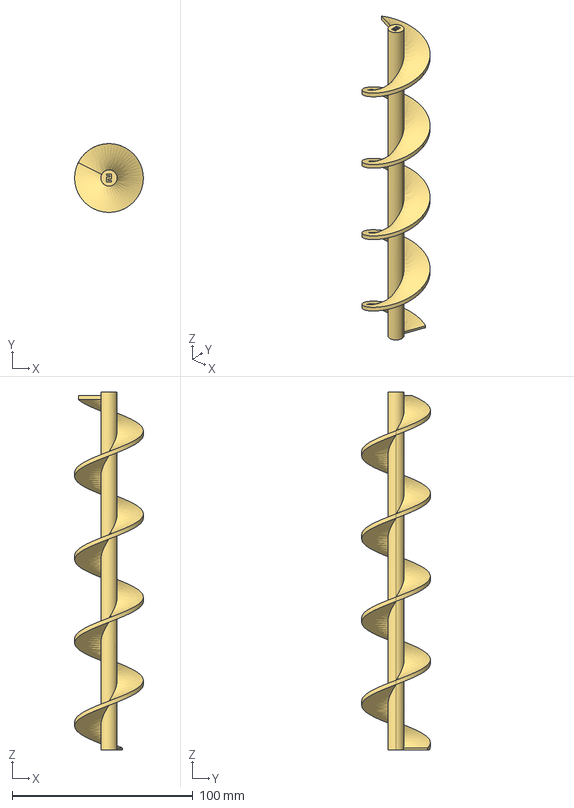
[picture p45: CAD file, 2026-11-08]
output/auger_upper.step
38.0 x 38.0 x 198.0 mm
