ignacio82/grav-mass/output/track_seg_06.step

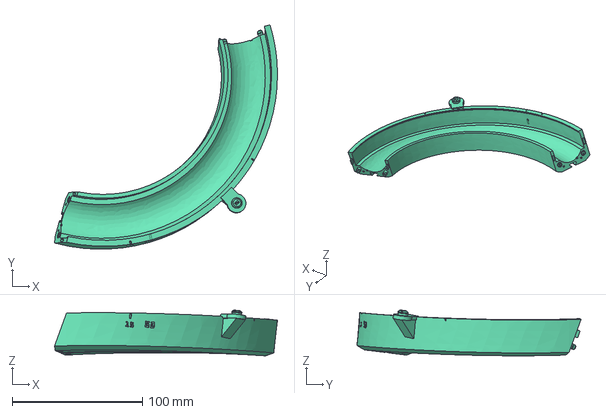
[picture p46: CAD file, 2026-11-08]
output/track_seg_06.step
171.2 x 172.1 x 35.0 mm
