ignacio82/grav-mass/output/bracket_14.step

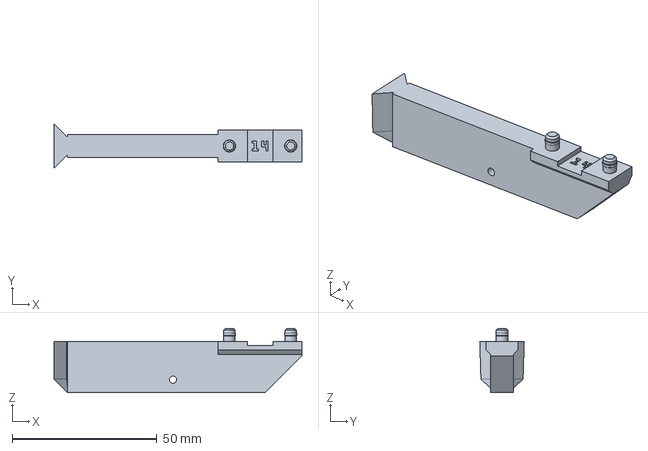
[picture p47: CAD file, 2026-11-08]
output/bracket_14.step
85.8 x 15.4 x 22.2 mm
