ignacio82/grav-mass/output/bracket_13.step

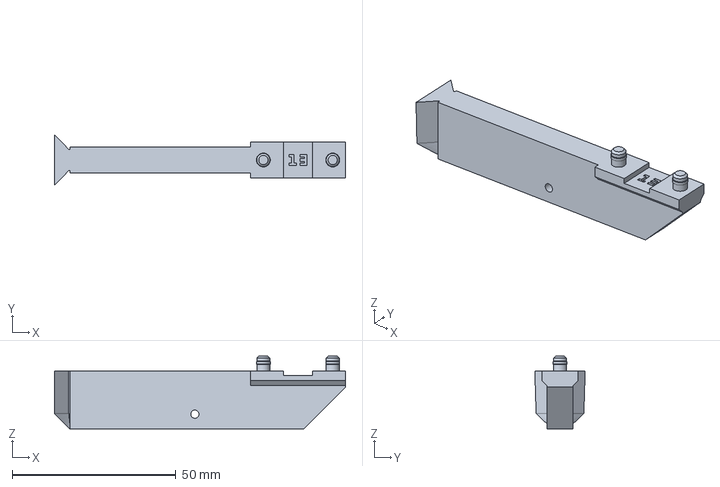
[picture p48: CAD file, 2026-11-08]
output/bracket_13.step
88.9 x 15.4 x 22.2 mm
