ignacio82/grav-mass/output/bracket_24.step

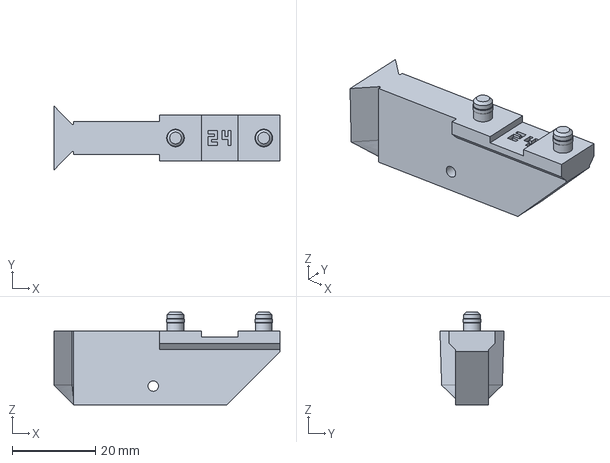
[picture p49: CAD file, 2026-11-08]
output/bracket_24.step
54.3 x 15.4 x 22.2 mm
