ignacio82/grav-mass/output/track_seg_07.step

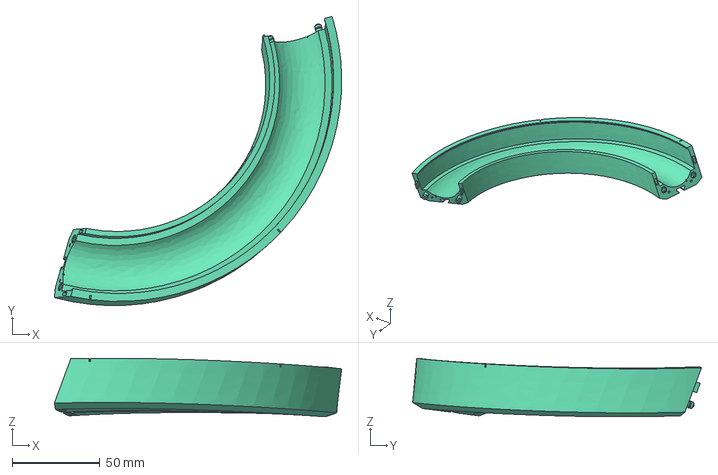
[picture p50: CAD file, 2026-11-08]
output/track_seg_07.step
163.4 x 164.4 x 33.3 mm
