ignacio82/grav-mass/output/planet_mars.step

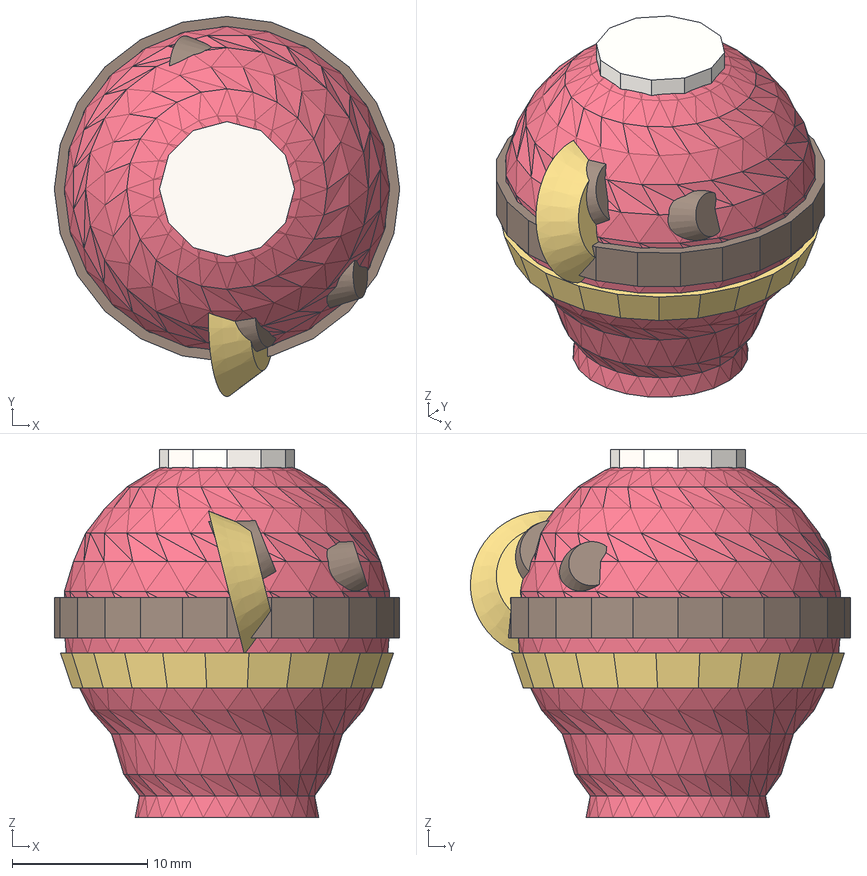
[picture p51: CAD file, 2026-11-08]
output/planet_mars.step
25.6 x 28.2 x 27.3 mm
mars_terracotta_body
mars_ochre_tharsis_hellas
mars_basalt_canyon_olympus_2
mars_basalt_canyon_olympus_1
mars_alabaster_polar_cap
