ignacio82/grav-mass/output/Apple_Hemisphere_B.step

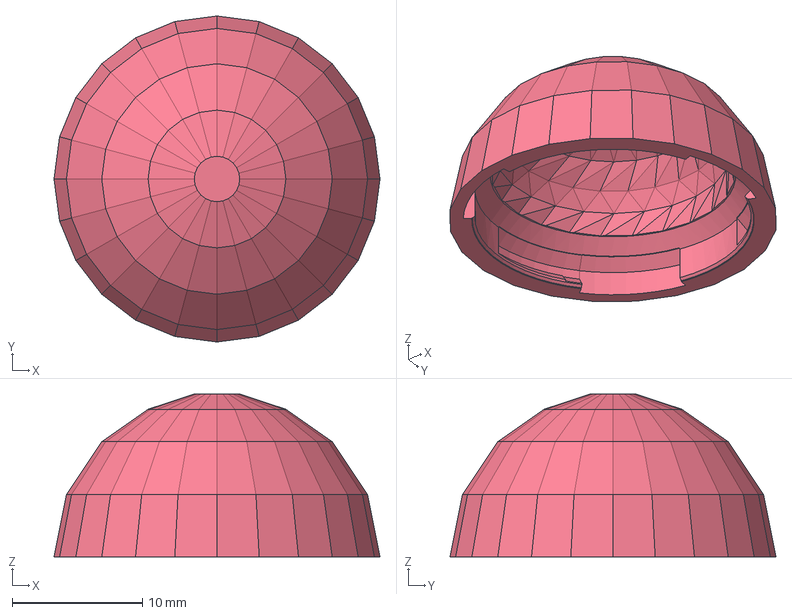
[picture p52: CAD file, 2026-11-08]
output/Apple_Hemisphere_B.step
25.0 x 25.0 x 12.5 mm
