ignacio82/grav-mass/output/bracket_07.step

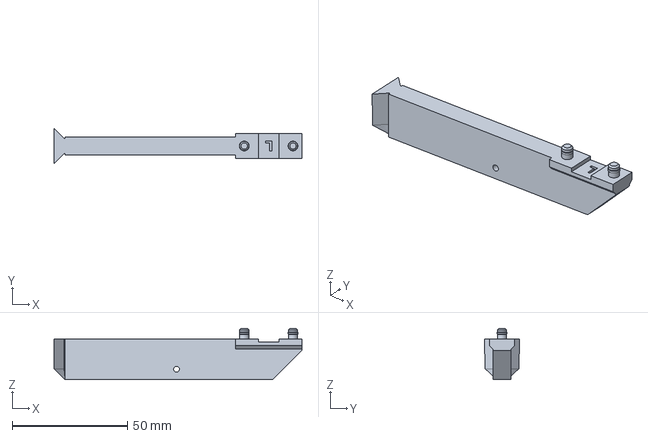
[picture p53: CAD file, 2026-11-08]
output/bracket_07.step
107.8 x 15.4 x 22.2 mm
