ignacio82/grav-mass/output/track_seg_14_top_entry.step

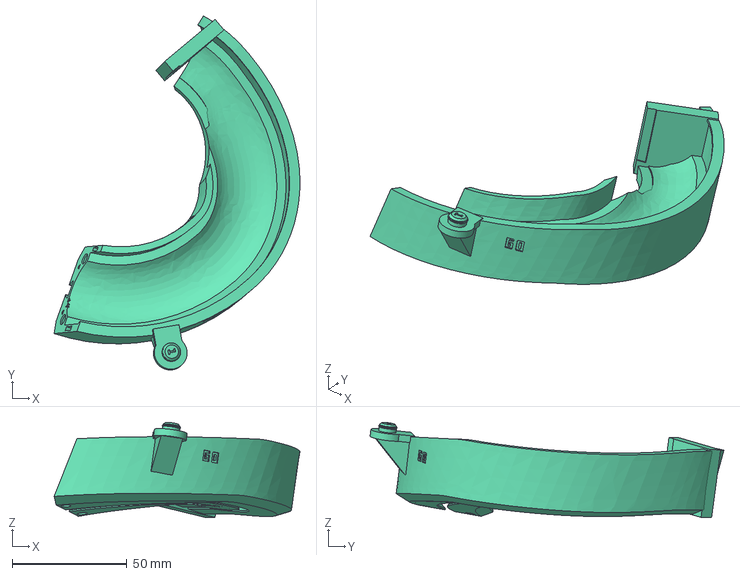
[picture p54: CAD file, 2026-11-08]
output/track_seg_14_top_entry.step
106.9 x 154.0 x 41.4 mm
