ignacio82/grav-mass/output/bracket_05.step

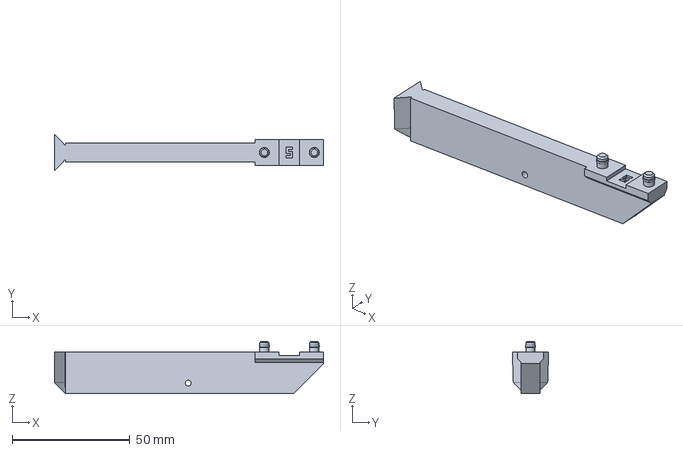
[picture p55: CAD file, 2026-11-08]
output/bracket_05.step
114.1 x 15.4 x 22.2 mm
