ignacio82/grav-mass/output/planet_uranus.step

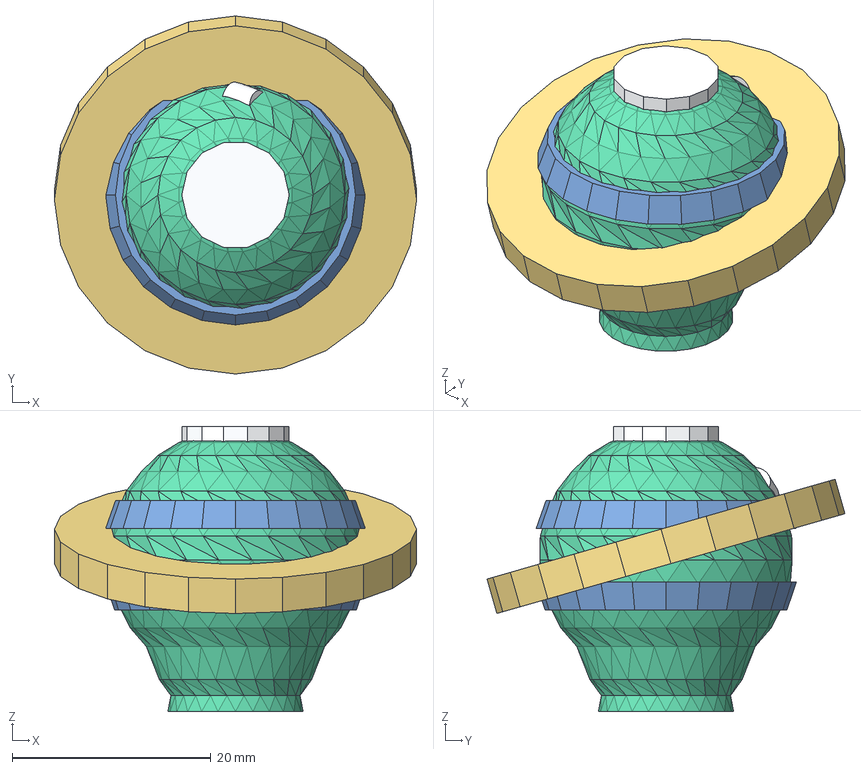
[picture p56: CAD file, 2026-11-08]
output/planet_uranus.step
36.4 x 36.0 x 28.7 mm
uranus_cyan_ice_globe
uranus_cobalt_latitude_bands_3
uranus_cobalt_latitude_bands_2
uranus_cobalt_latitude_bands_1
uranus_gold_epsilon_ring
uranus_white_polar_hood_2
uranus_white_polar_hood_1
