ignacio82/grav-mass/output/trunk_mid.step

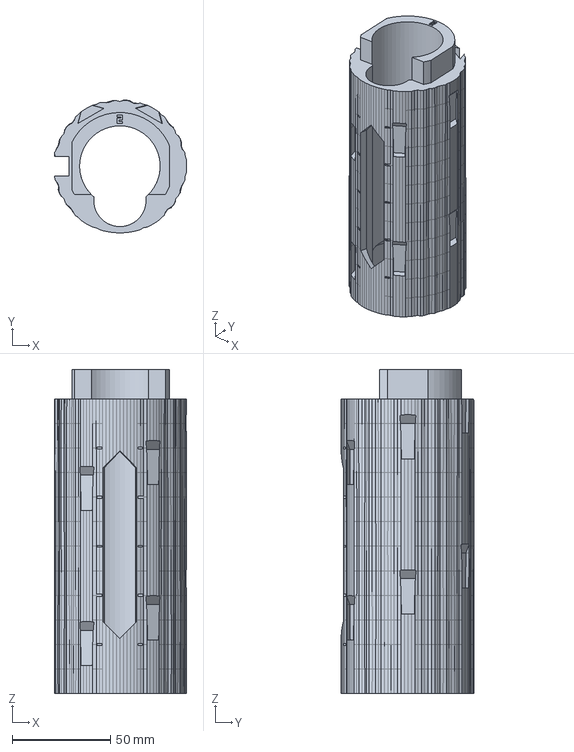
[picture p57: CAD file, 2026-11-08]
output/trunk_mid.step
67.4 x 67.6 x 165.0 mm
