ignacio82/grav-mass/output/bracket_11.step

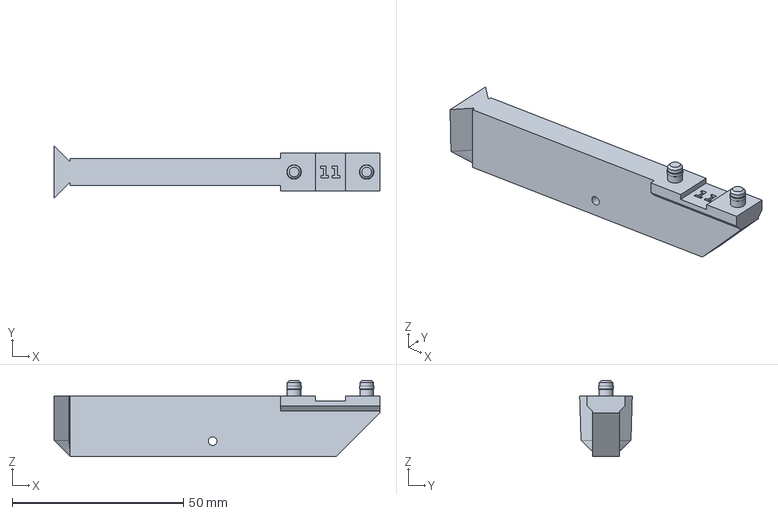
[picture p58: CAD file, 2026-11-08]
output/bracket_11.step
95.2 x 15.4 x 22.2 mm
