ignacio82/grav-mass/output/bracket_16.step

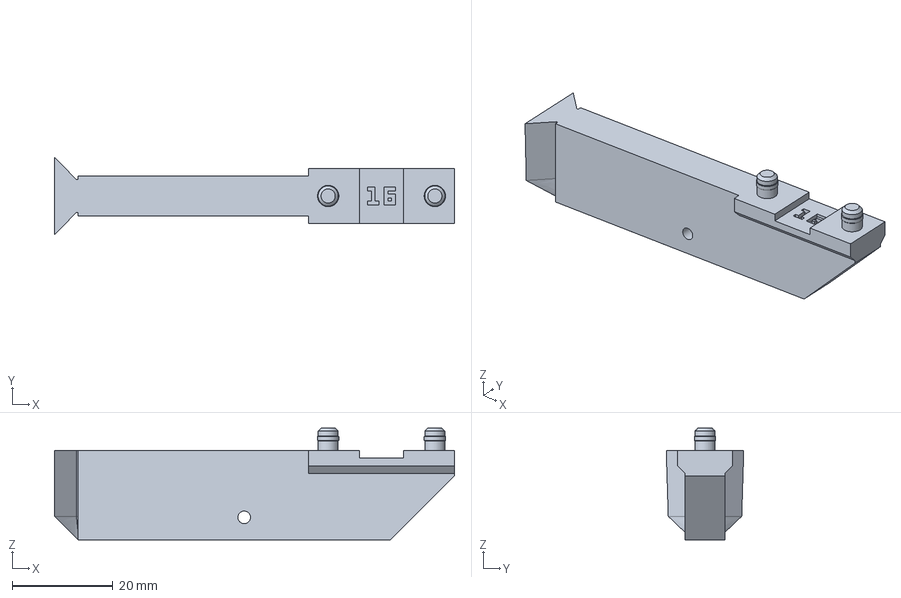
[picture p59: CAD file, 2026-11-08]
output/bracket_16.step
79.5 x 15.4 x 22.2 mm
