ignacio82/grav-mass/output/bracket_17.step

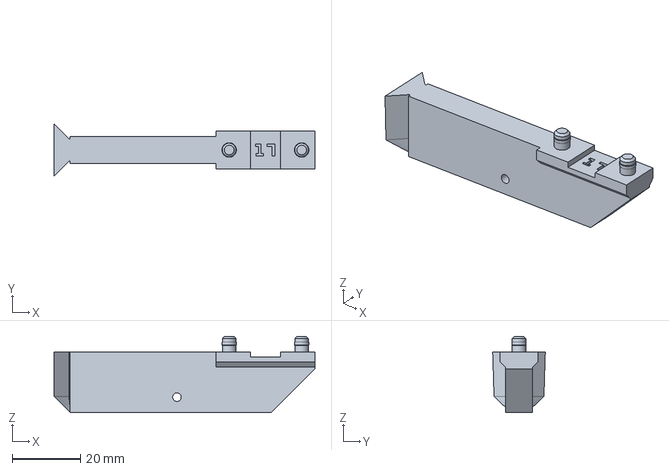
[picture p60: CAD file, 2026-11-08]
output/bracket_17.step
76.3 x 15.4 x 22.2 mm
