ignacio82/grav-mass/output/bracket_21.step

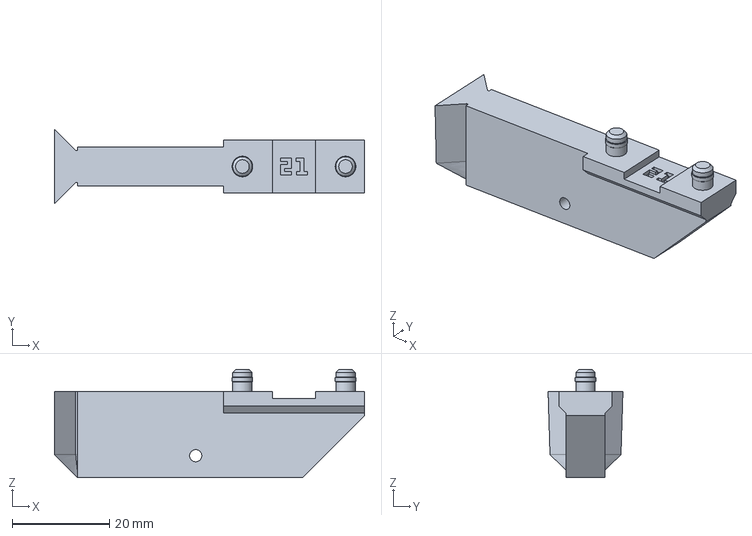
[picture p61: CAD file, 2026-11-08]
output/bracket_21.step
63.7 x 15.4 x 22.2 mm
