ignacio82/grav-mass/output/bracket_08.step

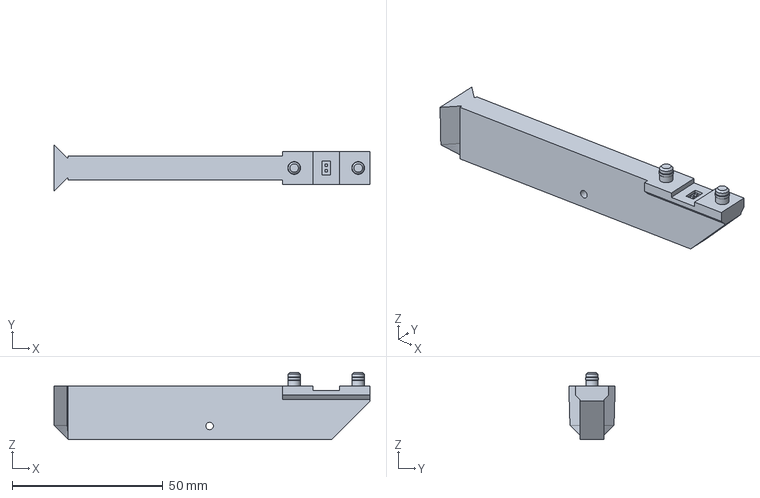
[picture p62: CAD file, 2026-11-08]
output/bracket_08.step
104.7 x 15.4 x 22.2 mm
