ignacio82/grav-mass/output/bracket_01.step

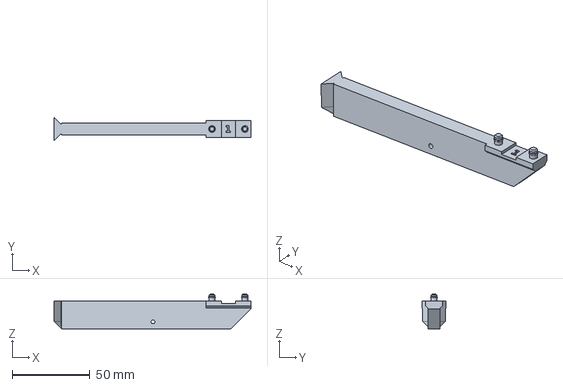
[picture p63: CAD file, 2026-11-08]
output/bracket_01.step
126.7 x 15.4 x 22.2 mm
