ignacio82/grav-mass/output/bracket_10.step

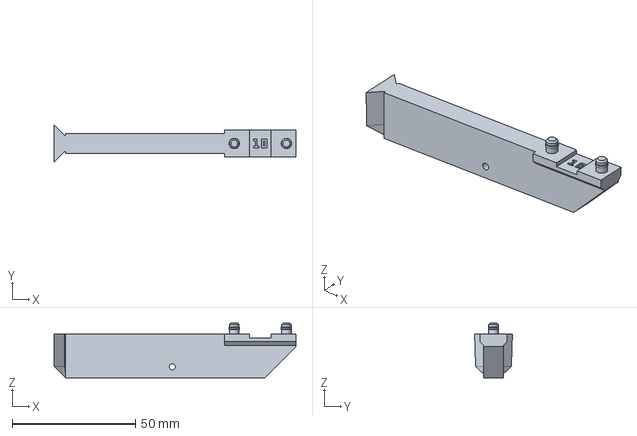
[picture p64: CAD file, 2026-11-08]
output/bracket_10.step
98.4 x 15.4 x 22.2 mm
