ignacio82/grav-mass/output/trunk_base.step

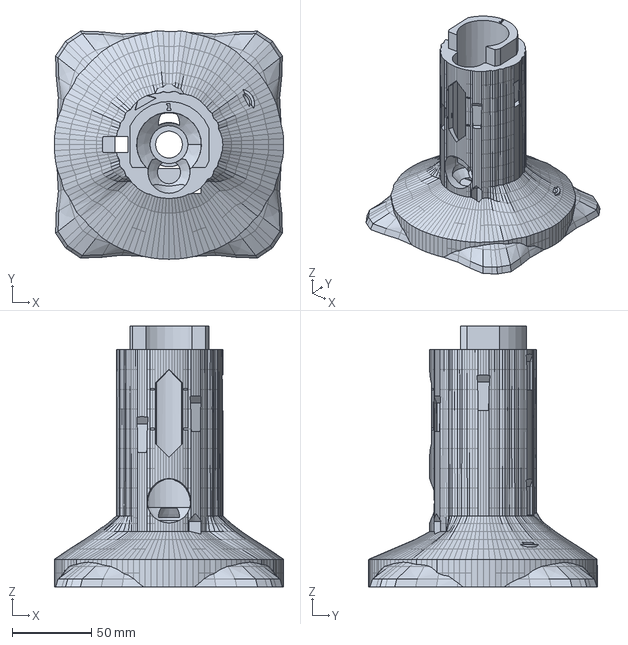
[picture p65: CAD file, 2026-11-08]
output/trunk_base.step
145.0 x 144.5 x 165.0 mm
