ignacio82/grav-mass/output/planet_venus.step

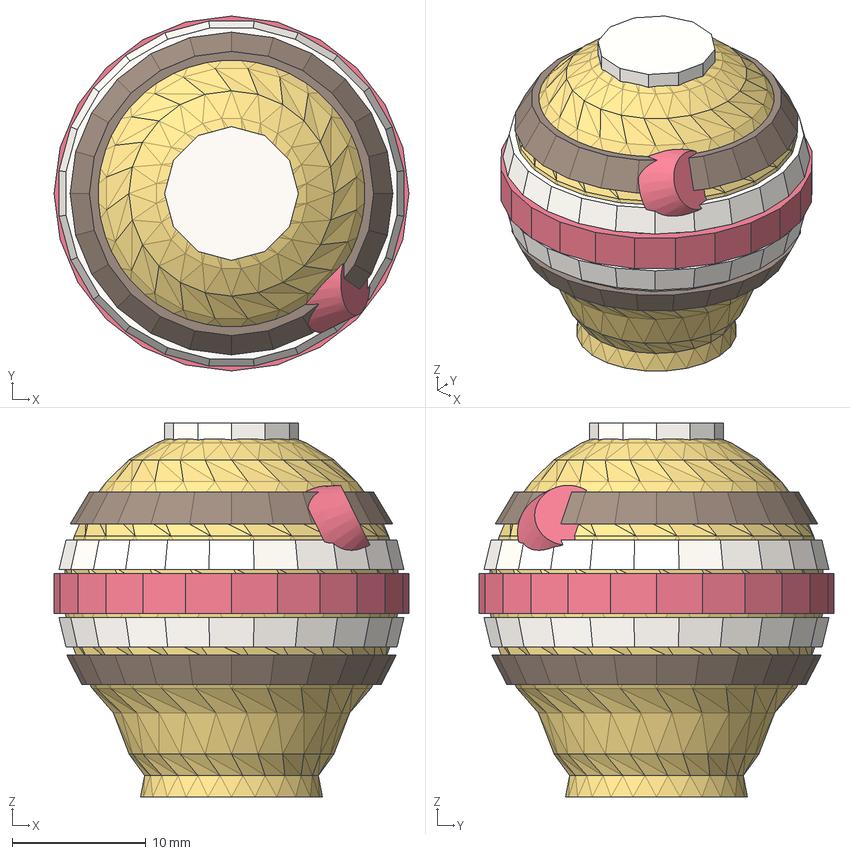
[picture p66: CAD file, 2026-11-08]
output/planet_venus.step
26.5 x 26.5 x 28.0 mm
venus_gold_cloud_deck
venus_alabaster_y_waves_3
venus_alabaster_y_waves_2
venus_alabaster_y_waves_1
venus_umber_vortex_collars_2
venus_umber_vortex_collars_1
venus_crimson_superrotation
