ignacio82/grav-mass/output/bracket_09.step

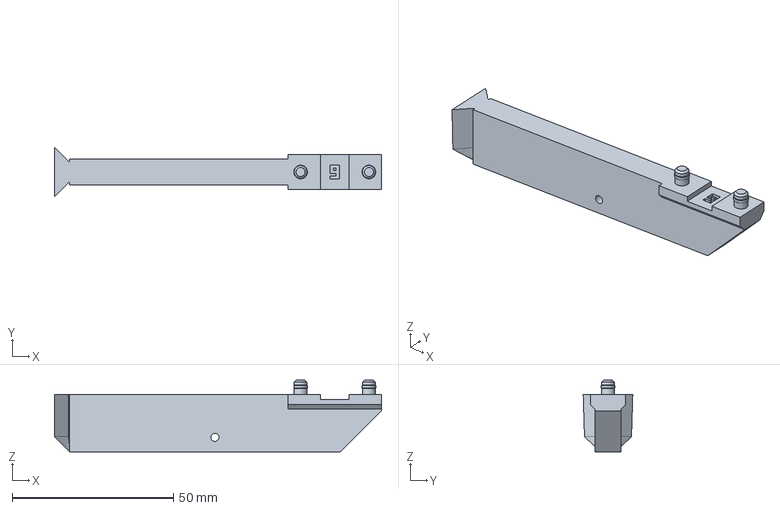
[picture p67: CAD file, 2026-11-08]
output/bracket_09.step
101.5 x 15.4 x 22.2 mm
