ignacio82/grav-mass/output/Apple_Hemisphere_A.step

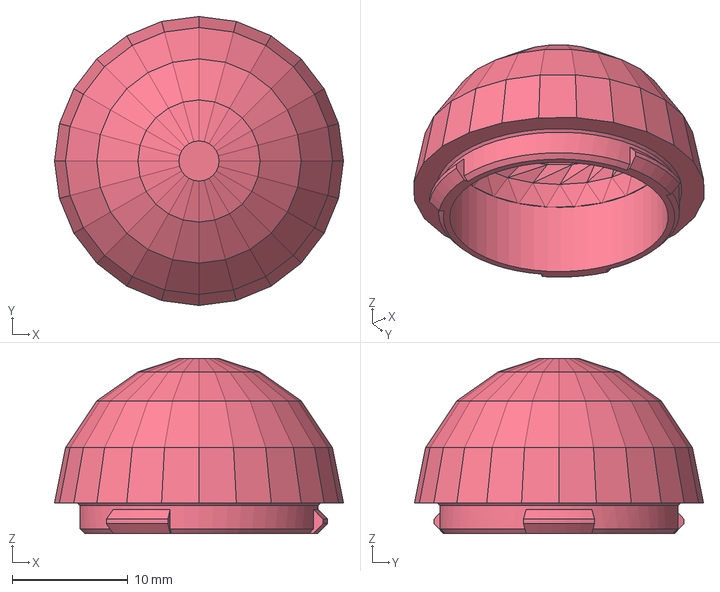
[picture p68: CAD file, 2026-11-08]
output/Apple_Hemisphere_A.step
25.0 x 25.0 x 15.2 mm
