ignacio82/grav-mass/output/planet_neptune.step

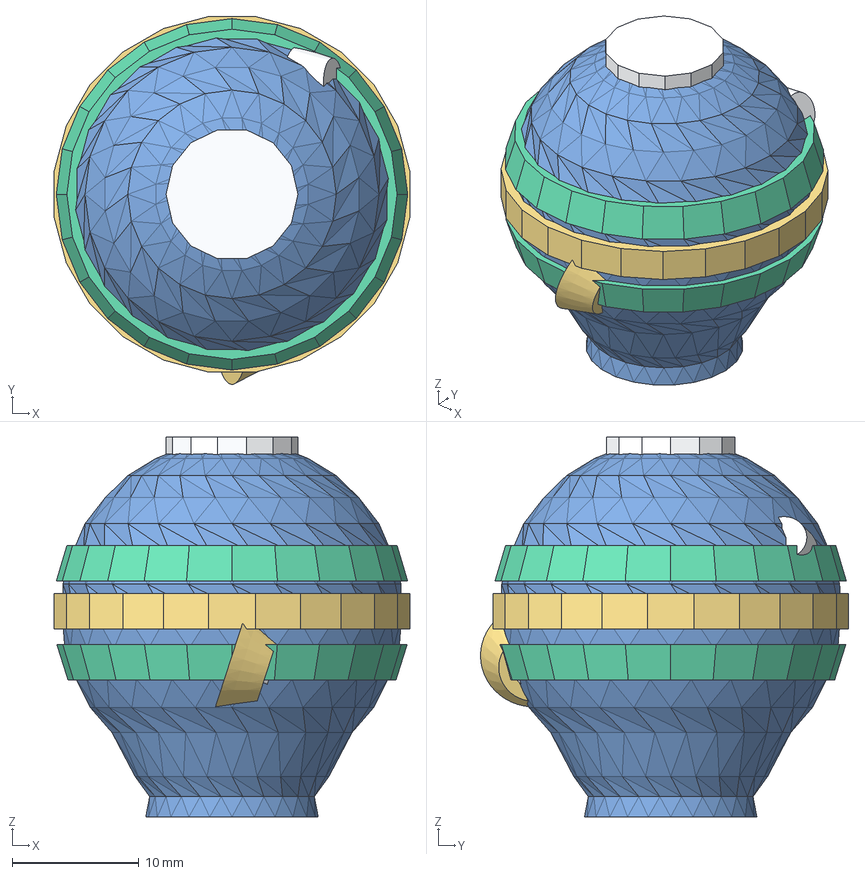
[picture p69: CAD file, 2026-11-08]
output/planet_neptune.step
28.0 x 29.0 x 29.9 mm
neptune_cobalt_ice_globe
neptune_teal_wind_belts_2
neptune_teal_wind_belts_1
neptune_gold_dark_spot_ring
neptune_white_cirrus_scooter_3
neptune_white_cirrus_scooter_2
neptune_white_cirrus_scooter_1
