ignacio82/grav-mass/output/track_seg_09.step

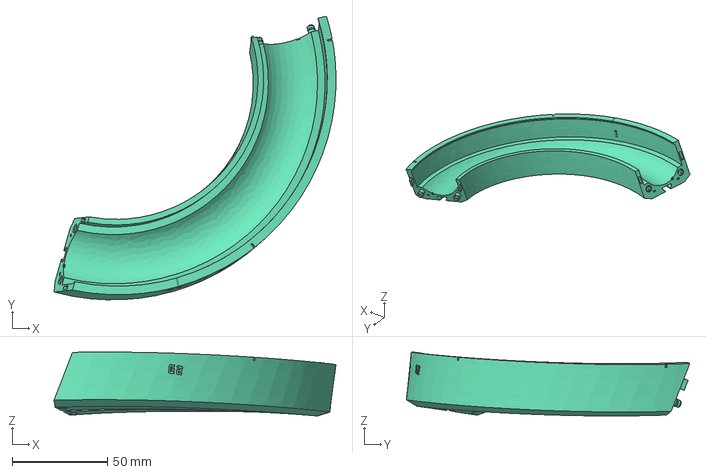
[picture p70: CAD file, 2026-11-08]
output/track_seg_09.step
148.1 x 148.9 x 33.6 mm
