ignacio82/grav-mass/output/bracket_04.step

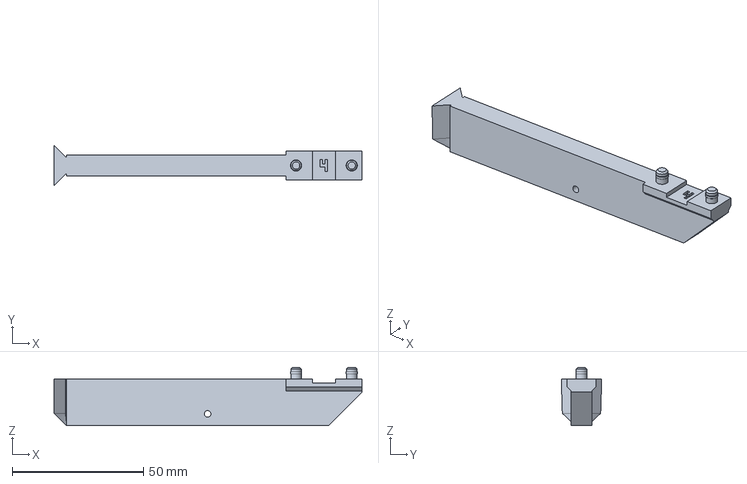
[picture p71: CAD file, 2026-11-08]
output/bracket_04.step
117.3 x 15.4 x 22.2 mm
