ignacio82/grav-mass/output/bracket_06.step

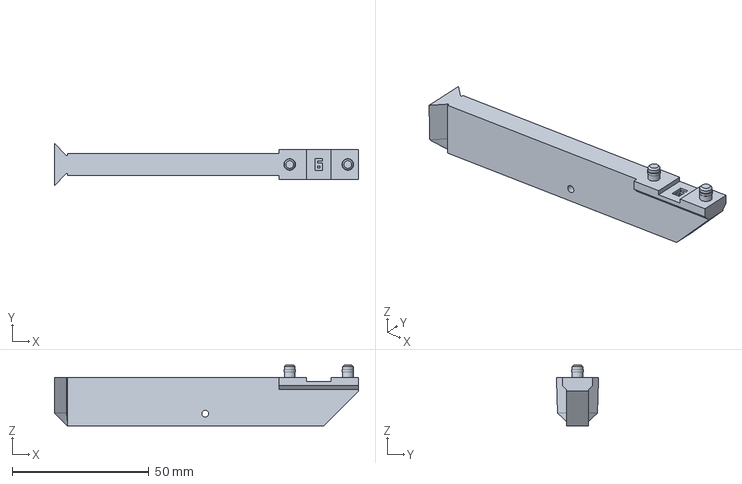
[picture p72: CAD file, 2026-11-08]
output/bracket_06.step
111.0 x 15.4 x 22.2 mm
