ignacio82/grav-mass/output/planet_earth.step

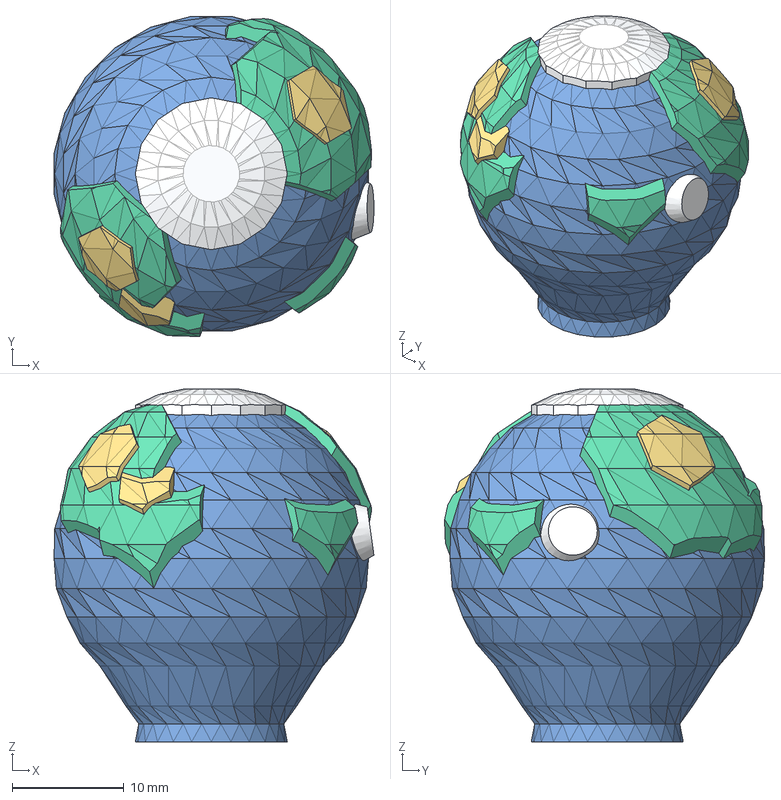
[picture p73: CAD file, 2026-11-08]
output/planet_earth.step
28.6 x 28.6 x 31.5 mm
earth_cobalt_ocean_globe
earth_emerald_continents
earth_gold_mountain_ranges_2
earth_gold_mountain_ranges_1
earth_white_polar_ice_clouds_3
earth_white_polar_ice_clouds_2
earth_white_polar_ice_clouds_1
