ignacio82/grav-mass/output/bracket_02.step

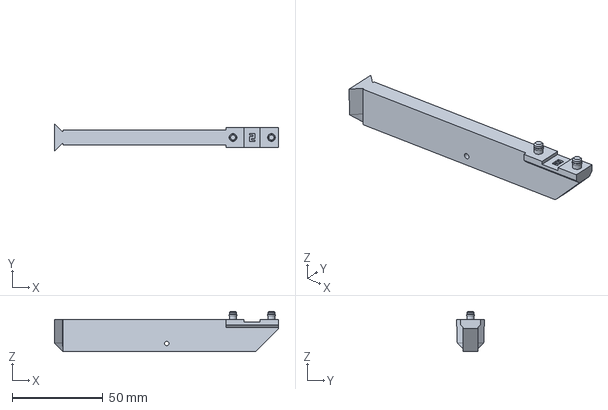
[picture p74: CAD file, 2026-11-08]
output/bracket_02.step
123.6 x 15.4 x 22.2 mm
