ignacio82/grav-mass/output/golden_apple_topper.step

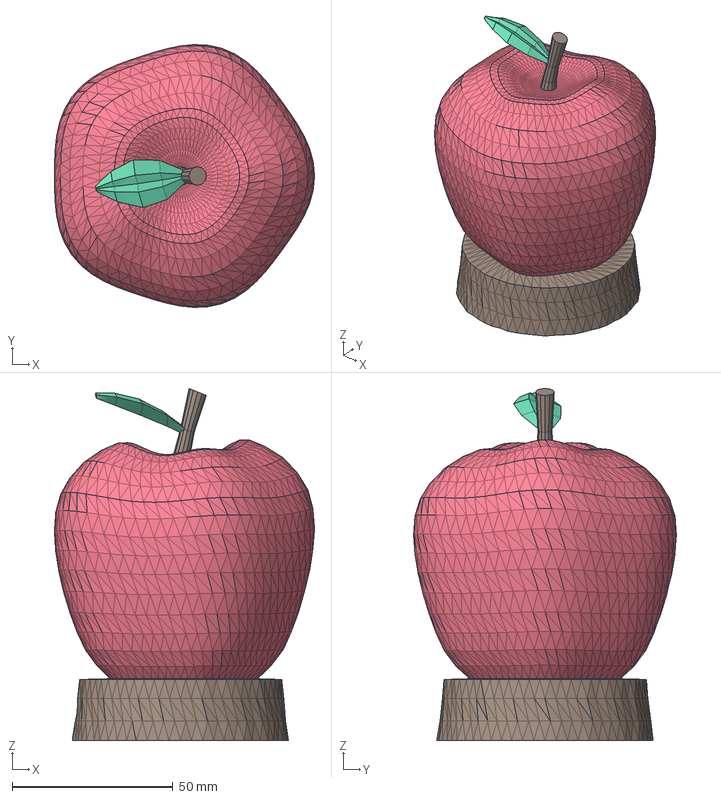
[picture p75: CAD file, 2026-11-08]
output/golden_apple_topper.step
81.0 x 81.8 x 109.6 mm
apple_red_shell
apple_brown_stem
apple_brown_trunk_collar_1
apple_green_leaf
