ignacio82/grav-mass/output/bracket_18.step

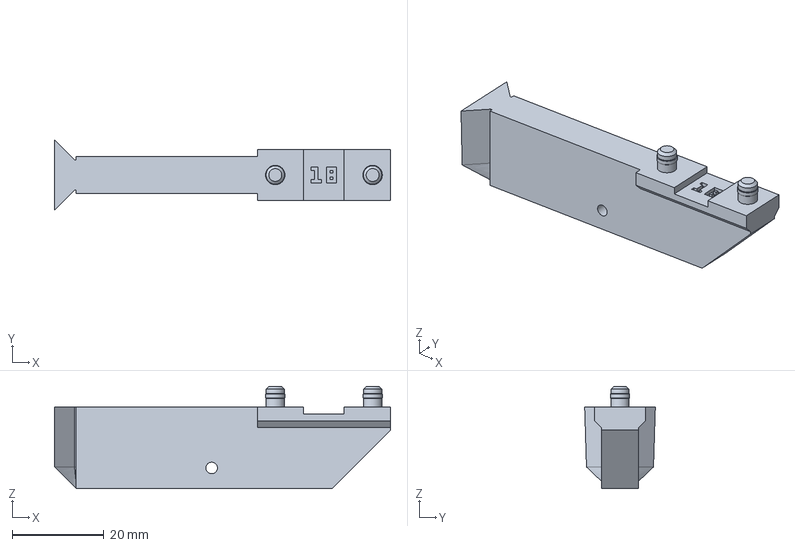
[picture p76: CAD file, 2026-11-08]
output/bracket_18.step
73.2 x 15.4 x 22.2 mm
