ignacio82/grav-mass/(list of files, cad)

Other CAD files:
output/track_seg_04.step
output/track_seg_01.step
output/track_seg_03.step
output/track_seg_02.step
output/Apple_Hemisphere_A.stl
output/Apple_Hemisphere_B.stl
output/Base_Bottom_Cover.stl
output/Battery_Cover.stl
output/Conduit_Cover_Strip.stl
output/Magic_LED_Wand.stl
output/Motor_Clutch_Driver.stl
output/Servo_Or_030_Adapter.stl
output/auger_lower.stl
output/auger_upper.stl
output/bracket_01.stl
output/bracket_02.stl
output/bracket_03.stl
output/bracket_04.stl
output/bracket_05.stl
output/bracket_06.stl
output/bracket_07.stl
output/bracket_08.stl
output/bracket_09.stl
output/bracket_10.stl
output/bracket_11.stl
output/bracket_12.stl
output/bracket_13.stl
output/bracket_14.stl
output/bracket_15.stl
output/bracket_16.stl
output/bracket_17.stl
output/bracket_18.stl
output/bracket_19.stl
output/bracket_20.stl
output/bracket_21.stl
output/bracket_22.stl
output/bracket_23.stl
output/bracket_24.stl
output/golden_apple_topper.stl
output/planet_earth.stl
output/planet_jupiter.stl
output/planet_mars.stl
output/planet_mercury.stl
output/planet_neptune.stl
output/planet_saturn.stl
output/planet_uranus.stl
output/planet_venus.stl
output/track_seg_01.stl
output/track_seg_02.stl
output/track_seg_03.stl
output/track_seg_04.stl
output/track_seg_05.stl
output/track_seg_06.stl
output/track_seg_07.stl
output/track_seg_08.stl
output/track_seg_09.stl
output/track_seg_10.stl
output/track_seg_11.stl
output/track_seg_12.stl
output/track_seg_13.stl
output/track_seg_14_top_entry.stl
output/trunk_base.stl
output/trunk_mid.stl
output/trunk_top.stl
