ignacio82/grav-mass/docs/ASSEMBLY.md

# 🔧 Step-by-Step Physical Assembly Instructions

> **💡 Interactive 3D Tutorial:** You can follow every connection piece-by-piece in 3D using the **[Live 3D Assembly Studio (`newton.martinez.fyi`)](https://newton.martinez.fyi/)** (`Step-by-Step Assembly & Exploded View` tab → `⏮ Prev Piece` / `Next Piece ⏭`).

## 🔢 Hidden Inner Assembly Numbering System (Zero Visible Marks When Assembled!)
Every multi-piece subsystem has its **assembly order number debossed into an internal/mating surface** so you can identify every part at a glance during assembly, while **100% of the numbers are hidden inside joints, sockets, or bores once assembled**:

| Subsystem | Engraved Mark | Where to Find It (Before Assembly) | How It Hides (Once Assembled) |
| :--- | :---: | :--- | :--- |
| **Apple Marble Hemispheres** | **`A`**, **`B`** | Inside the hollow central core ceiling (`Z = 10.6 mm`) of `Apple_Hemisphere_A` and `Apple_Hemisphere_B` | Sealed inside the `Ø 25.0 mm` sphere once `A` and `B` snap together |
| **Archimedes Auger Halves** | **`1`**, **`2`** | **`1`** on the flat top of `auger_lower`'s male hex peg (`Z = 208 mm`); **`2`** on the flat top of `auger_upper`'s shaft (`Z = 198 mm`) | **`1`** hides inside `auger_upper`'s bottom hex socket; **`2`** hides deep inside the top of `trunk_top` |
| **Bark-Textured Trunk & Topper Stack** | **`1` → `2` → `3` → `4`** | **`1`** on top tenon rim of `trunk_base`; **`2`** on top tenon rim of `trunk_mid`; **`3`** on top Crown Centering Tenon Collar of `trunk_top`; **`4`** inside the lantern ceiling of `golden_apple_topper` | Each number is covered by the female socket of the section stacked directly on top of it |
| **Cantilever Branch Brackets** | **`1` – `24`** *(Station Digit + `1–4` Tier Bars)* | Arabic station number **`1`** through **`24`** in the recessed top saddle between the two `Ø 4.0 mm` pegs **plus** `1`–`4` horizontal V-notch tier bars on the `-X` dovetail back face | Top digit is covered by the underside of the track segment; dovetail bars hide inside the trunk slot |
| **Helical Track Segments** | **`1` – `14`** | Engraved on the `15°` **scarf-joint mating end face(s)** beside the **Twin `Ø 3.80 mm` Male Snap-Lock Tenon Pegs / `Ø 4.30 mm` Female Sockets** (`track_seg_01` = `1` at bottom → `track_seg_14_top_entry` = `14` at top) | Pressed face-to-face against the adjacent track segment inside the snap-locked scarf joint |
| **Solar System Planets & Balcony Pegs** | **`1` – `8`** *(Top to Bottom)* | **`1`** (Mercury) to **`8`** (Neptune) engraved inside the top ceiling of each planet's bottom LED bore **and** on the flat top of the matching `Ø 7.60 mm` track balcony peg | Hidden inside the planet's bottom bore once the planet is pushed onto its matching balcony peg (`1`→`1` .. `8`→`8`) |

---

## Step 1: Assemble the 6 Glowing Rolling Apple Marbles (`A` + `B` Quarter-Turn Bayonet Twist-Lock)
1. Take the 6 pairs of [`Apple_Hemisphere_A`](../output/Apple_Hemisphere_A.stl) (marked **`A`** inside the central cavity, featuring the **3-lug male bayonet collar** `R_neck = 10.30 mm` / `R_lug = 11.15 mm` with a `45°` elephant's-foot relief chamfer) and [`Apple_Hemisphere_B`](../output/Apple_Hemisphere_B.stl) (marked **`B`** inside the central cavity, featuring the **3 wide vertical entry keyway slots and clockwise undercut locking tunnels**).
2. **Insert the Y-Shape 3-LED Light (`KC013`):**
   - Drop a **`Ø 18.0 × 6.5 mm` [Bambu Lab Y-Shape LED Light with Magnetic Control Switch (`KC013`)](https://us.store.bambulab.com/products/y-shape-led-light-with-magnetic-control-switch)** directly into the **`Ø 18.70 × 7.30 mm`** equatorial chamber of `Apple_Hemisphere_B`. Its 3 Y-spaced LEDs illuminate the entire thin-shell hollow marble, while its steel `CR1632` battery provides centered rolling momentum (no extra weights or nuts needed).
3. **Drop In & Quarter-Turn Twist to Lock:** Align the **3 male bayonet lugs** on `Apple_Hemisphere_A` with the **3 open vertical keyway slots** on `Apple_Hemisphere_B`—the two halves drop flush together with **zero force** (`+0.44 mm` clearance, no bending rigid PLA required). Then **twist `Apple_Hemisphere_A` `45°` clockwise ("righty-tighty")** to lock the 3 lugs underneath the solid retaining ceiling so the halves cannot separate during rolling or drops. Repeat for all 6 marbles.

## Step 2: Install the N20 Motor, Rear 12V DC Barrel Jack (`J1`), 5V Buck Converter & M5Stack ESPHome Controller (`A092` + `C008`) in `trunk_base` (`#1`)
1. Turn [`trunk_base`](../output/trunk_base.stl) (marked **`1`** on its top tenon rim; `Ø 185.0 mm` diagonal root footprint with a cavernous **`Ø 135.0 × 50.0 mm` Hollow Root Vault** providing **`> 150,000 mm³` (`150+ cm³`)** of open cable slack space) upside down to access the bottom vault.
2. **Mount the Rear `-X` `12V` DC Barrel Jack (`J1`, `B07C7VSRBG`):**
   - Thread the pre-wired **`5.5 × 2.1 mm` Female Panel-Mount DC Barrel Jack (`B07C7VSRBG`, `M11 × 0.75`)** through the rear `-X` **`Ø 11.40 mm` port** (`Z = 10.0 mm`) on `trunk_base` and tighten its hex nut. Route its `18 AWG` pigtails into the vault through `dc_jack_vault_portal` to `WAGO-1 (+12V_BUS)` (via inline `5A` fuse `F0`, `B087BT1PH3`) and `WAGO-2 (STAR_GND)` (`B07NKT2P2F`).
3. **Slide the N20 Gear Motor (`B0BFRPMSW6`) Into the Central Shroud Tower:**
   - Slide the **`12V DC 150 RPM N20` Micro Metal Gear Motor (`B0BFRPMSW6`)** + [`Servo_Or_030_Adapter`](../output/Servo_Or_030_Adapter.stl) upward into the central **`Ø 28.0 mm` Isolated Motor & Clutch Shroud Tower** so its `Ø 3.0 mm` D-shaft protrudes upward through the `Z = 36 mm` ceiling into the auger bore, and route its 2-wire lead out the bottom `-Y` shroud wire exit notch (`6.5 × 7.6 mm`). Because the `Ø 28.0 mm` shroud completely encloses the motor and `Ø 20.0 mm` safety clutch/coupler, loose cables in the vault can **never** rub against spinning parts.
4. **Drop Boards into the Hollow Root Vault (`>= 18.0 mm` Finger Access):**
   - **Branch 1 & 3 — M5Stack Controller & Motor Driver (`A092` + `C008`):** Snap the **M5Stack ATOM Lite ESP32 (`C008`, `24.0 × 24.0 × 9.5 mm`)** onto the **Atomic H-Bridge Driver Base (`A092`, `48.0 × 24.0 × 18.0 mm`)** and seat into the stepped `-Y` cradle (`49.2 × 25.2 × 20.3 mm` at `(0, -33.0 mm)`). Connect `WAGO-1 (+12V_BUS)` (via `2A` inline fuse `F1`) and `WAGO-2 (STAR_GND)` (seated in the `+X` `19.8 × 31.2 × 18.0 mm` WAGO `221-415` organizer cradle at `(+44.5, -12.0 mm)`) to `A092` **`VIN`** and **`GND`** screw terminals (`A092`'s internal `MP1584EN` buck regulator automatically powers `C008` from `12V`—no USB-C cable needed!).
   - **Branch 2 — Dedicated UCTRONICS `12V → 5.0V 5A` LED Buck Converter (`B07XXWQ49N`):** Seat the **`UCTRONICS DC 9V–36V to 5V 5A` Screw-Terminal Buck Converter (`B07XXWQ49N` / `U6223`, `63.0 × 27.0 × 10.0 mm`)** into the dedicated `+Y` snap-in cradle (`64.2 × 28.2 × 12.0 mm` at `(-4.0, +36.5 mm)`) inside the Hollow Root Vault, fed from `WAGO-1 (+12V_BUS)` via `3A` inline fuse `F2` and `WAGO-2 (STAR_GND)` into its `VIN+` and `GND` screw terminals. Connect its `OUT+` and `GND` screw terminals (plus one `1000 µF 16V` bulk capacitor `B07WPWFSNQ`, `Ø 10.0 × 17.0 mm`) to **`WAGO-3 (+5V_LED)`** and **`WAGO-4 (GND_LED)`** (linked to `WAGO-2` Star Ground).
5. **Zero-Fuss Solder-Free Terminal Clamping & Cable Stuffing:**
   - Clamp the **`12V 150 RPM N20` Motor (`B0BFRPMSW6`)** leads into the **`M1` & `M2` screw terminals** on `A092`.
   - Plug the `200 mm` **M5Stack Grove2Dupont Cable (`A096`)** into `C008`'s `HY2.0-4P` Grove port. **IMPORTANT (`5V` Rail Isolation):** Leave the `A096` **`Red (+5V)` wire UNCONNECTED (cap inside an empty WAGO lever slot)** so the external `5V` LED buck converter never backfeeds `A092`'s internal `5V` regulator! Connect `A096` `Black (GND)` to `WAGO-2` (`STAR_GND`).
   - Secure [`Battery_Cover`](../output/Battery_Cover.stl) (`2× M2.5 × 6 mm` screws `B0BYF4X65F`) and snap [`Base_Bottom_Cover`](../output/Base_Bottom_Cover.stl) (`3.0 mm` thick service lid with ventilation louvers, 4× captive-magnet tabs, and an upward **`Ø 23.60 × 2.8 mm` Snap-In Hollow Retaining Ring** that clicks concentrically into `trunk_base`'s central `Ø 24.00 mm` bottom shroud bore with zero screws needed) onto the bottom access port.
6. From inside the top of `trunk_base`, press [`Motor_Clutch_Driver`](../output/Motor_Clutch_Driver.stl) (gold hex driver) down onto the N20 motor's D-shaft.

## Step 3: Couple & Insert the Two-Stage Archimedes Screw Auger (`#1` + `#2`)
1. Identify [`auger_lower`](../output/auger_lower.stl) (engraved with **`1`** on the flat top of its male hex peg) and [`auger_upper`](../output/auger_upper.stl) (engraved with **`2`** on the flat top of its central shaft).
2. Slide the hexagonal male peg (`#1`) at the top of `auger_lower` into the matching female hexagonal socket in the bottom of `auger_upper` (`#2`), hiding the **`1`** inside the joint and aligning the helical screw flights into one continuous spiral.
3. Lower the assembled auger into `trunk_base` so the bottom female hex socket of `auger_lower` engages the hex head of `Motor_Clutch_Driver`. Spin the auger by hand slightly to verify smooth seating.

## Step 4: Stack the Bark-Textured Trunk Sections (`#1` → `#2` → `#3`)
1. Take [`trunk_mid`](../output/trunk_mid.stl) (engraved with **`2`** on its top tenon rim) and lower its bottom keyed female socket onto the top male tenon (`#1`) of `trunk_base`, hiding the **`1`** inside the joint (`15 mm` overlap).
2. Take [`trunk_top`](../output/trunk_top.stl) (engraved with **`3`** on its top Crown Centering Tenon Collar) and stack it onto `trunk_mid`'s top tenon (`#2`), hiding the **`2`** inside the joint.
3. Confirm that the organic vertical **bark ridges**, internal `-Y` ball flute, **gothic-arched front viewing windows**, and the oversized **`10.0 mm wide × 8.0 mm deep` rear `-X` Connector-Pass-Through wiring conduit** align seamlessly from bottom to top.

## Step 5: Slide in All 24 Exact-Radius Cantilever Branch Brackets (Sorted by Engraved `1–24` Numbers)
1. **Plates 3 & 4** ([`Plate_3_SingleColor_Brown_Brackets_01_To_12.3mf`](../output/3mf/Plate_3_SingleColor_Brown_Brackets_01_To_12.3mf) and [`Plate_4_SingleColor_Brown_Brackets_13_To_24.3mf`](../output/3mf/Plate_4_SingleColor_Brown_Brackets_13_To_24.3mf)) print all **24 exact-radius station brackets** ([`bracket_01`](../output/bracket_01.stl) through [`bracket_24`](../output/bracket_24.stl)) upright on `Z = 0` with zero supports. Each bracket has its exact station number (**`1` through `24`**) engraved face-up in the recessed top saddle between the two `Ø 4.0 mm` pegs **and** `1–4` horizontal tier bars on the back of its dovetail tenon (both hide completely once assembled):
   - **Lower 6 Stations (`1` to `6`, Tier 4, on Plate 3):** Slide [`bracket_01`](../output/bracket_01.stl)..[`bracket_06`](../output/bracket_06.stl) downward in ascending spiral order into the lowest 6 trunk dovetail slots (`theta = 60°..360°`, radii `141.9 mm` down to `126.1 mm`).
   - **Lower-Mid 6 Stations (`7` to `12`, Tier 3, on Plate 3):** Slide [`bracket_07`](../output/bracket_07.stl)..[`bracket_12`](../output/bracket_12.stl) into the next 6 slots (`theta = 420°..720°`, radii `123.0 mm` down to `107.2 mm`, including the precision cross-seam dovetails at `Z = 150 mm`).
   - **Upper-Mid 6 Stations (`13` to `18`, Tier 2, on Plate 4):** Slide [`bracket_13`](../output/bracket_13.stl)..[`bracket_18`](../output/bracket_18.stl) into the next 6 slots (`theta = 780°..1080°`, radii `104.1 mm` down to `88.3 mm`).
   - **Upper 6 Stations (`19` to `24`, Tier 1, on Plate 4):** Slide [`bracket_19`](../output/bracket_19.stl)..[`bracket_24`](../output/bracket_24.stl) into the upper 6 slots (`theta = 1140°..1440°`, radii `85.2 mm` down to `69.4 mm`, including the cross-seam dovetails at `Z = 300 mm`).

## Step 6: Snap Together the Helical Track Segments (`1` to `14`) via the Built-In Male/Female Snap-Lock Joint + Seam Brackets
1. Check the angled `15°` scarf-joint mating end faces of each green track segment—each segment is engraved with its sequence number **`1` through `14`** and features an **Integrated 4-Point Male-to-Female Snap-Lock Interlock + Underside Seam Bracket Sockets**:
   - **Uphill Face (`theta_end_deg` of Segments `1`–`13`):** Protrudes **Twin `Ø 3.80 × 5.0 mm` Under-Shoulder Male Snap-Lock Tenon Pegs** (with `Ø 4.08 mm` annular snap-detent rings and `45°` nose chamfers at `u = ±14.2 mm, v = -4.2 mm`) **PLUS Inner & Outer Sidewall Anti-Torsion Tongue Tabs** (`u = -18.5 mm` and `u = +18.8 mm`).
   - **Downhill Face (`theta_start_deg` of Segments `2`–`14`):** Features **Matching `Ø 4.30 × 5.6 mm` Female Snap-Lock Sockets** (with entry flare and `Ø 4.60 mm` internal snap-detent groove) **PLUS Matching Sidewall Anti-Torsion Slots**.
   - **Underside Seam Bracket Sockets (`120°, 240°, 360°, ..., 1560°`):** In addition to the midpoint bracket sockets (`60°, 180°, 300°, ...`), every segment end also includes underside `Ø 4.40 mm` vertical sockets at `u = ±10.6 mm` so the even-`60°` cantilever brackets lock directly under the segment seams!
2. Start at the bottom with **Segment `1`** ([`track_seg_01`](../output/track_seg_01.stl)):
   - Dock its inward spiral return chute (`-90°`) flush against the `-Y` bottom intake port of `trunk_base` (`Z = 50..57 mm`) and press its underside sockets onto the twin snap-lock pegs of the Tier `4` brackets at `60°` and `120°` (covering the **`1`** and **`2`** digits on the brackets!).
3. Continue upward in numerical order from **Segment `2`** ([`track_seg_02`](../output/track_seg_02.stl)) through **Segment `13`** ([`track_seg_13`](../output/track_seg_13.stl)):
   - Slide each segment's downhill **Female Sockets** directly onto the previous segment's uphill **Twin Male Snap-Lock Tenon Pegs + Sidewall Tongues** (`1` into `2`, `2` into `3`, ..., `12` into `13`) until the detent rings click flush along the `15°` downhill scarf joint, while clicking the underside sockets onto the bracket pegs below.
4. Finish the track at the top with **Segment `14`** ([`track_seg_14_top_entry`](../output/track_seg_14_top_entry.stl)):
   - Click its downhill Female Sockets (`14`) onto Segment `13`'s Male Snap-Tenons and dock its upper catch basin (`1710°`) flush against the `-Y` upper discharge spout of `trunk_top` (`Z = 425..435 mm`).
5. **Snap In the Full-Length Under-Track BTF-LIGHTING `DC5V` `WS2812B` Pebble/Seed Pixel Flexible Wire (`B0CCS11V7H`, Segment `1` → Segment `14`):**
   - Seat the starter end of the **[BTF-LIGHTING `DC5V` `WS2812B` Pebble/Seed Pixel Flexible Wire (`16.4ft / 50 LEDs`, `B0CCS11V7H`)](https://www.amazon.com/dp/B0CCS11V7H)** into the **`10.0 × 16.0 × 3.7 mm` starter feed pocket** on the underside of `track_seg_01` (right outside the `-Y` trunk intake port at `-70°`).
   - Press the `360°`-flexible 3-wire cord (`~3.4 × 1.4 mm`) and `50×` oval epoxy Pebble LEDs (`~6.2 × 3.2 mm`) upward through the **`4.6 mm` snap-in throat** into the **`8.0 × 3.6 mm` internal dovetail chamber** all the way up the `4.5`-turn spiral from `track_seg_01` to `track_seg_14_top_entry`. Because each `6.2 mm` wide oval pebble LED slips through the `4.6 mm` throat on an angle and lays flat inside the `8.0 mm` chamber above the twin `45°` retention lips, **the entire wire locks in mechanically with zero glue and zero tape!**
   - Feed the wire's 3-pin `JST-SM` input lead (and both red/black power-injection leads) through the **`cob_wire_entry_port`** (`7.5 × 12.0 × 6.5 mm` at `X = +16.5, Y = -31.5, Z = 35.0 mm`) on `trunk_base` and down `cob_wire_conduit` into the Hollow Root Vault: connect `White (GPIO26)` from the `A096` Grove cable to the center `DIN` pin, and clamp the `Red (+5V)` and `Black (GND)` power leads into **`WAGO-3 (+5V_LED)`** and **`WAGO-4 (GND_LED)`** from the dedicated `12V → 5V 5A` buck converter.

## Step 7: Install the Sparkleiot 16-Bit WS2812 RGB Ring, Snap On the 3× `Conduit_Cover_Strip` & Seat Red Apple Topper (`#4`)
1. Seat the **`Ø 45.0 mm` [Sparkleiot 16-Bit WS2812 RGB LED Ring (`B09YTMNGTD`)](https://www.amazon.com/dp/B09YTMNGTD)** (LEDs facing UP) flat into the **`Ø 46.2 × 2.5 mm` recessed ring seat** on the top rim of [`trunk_top`](../output/trunk_top.stl) (`Z = 447.5 mm`, sitting `12 mm` above the top of the auger and completely above the `-Y` marble discharge chute so it can never interfere with a marble).
2. Plug the **[3-Pin `JST-SM` Extension Cable (`B0CT827QQC`)](https://www.amazon.com/dp/B0CT827QQC)** into the ring's `SM2.54-3P` connector (**zero soldering**) and thread the pre-terminated connector straight down the oversized **`10.0 mm wide × 8.0 mm deep` rear `-X` Connector-Pass-Through trunk wiring conduit** (`trunk_top → trunk_mid → trunk_base`) into the Hollow Root Vault (no cutting or de-pinning required!). Connect its center `DIN` pin to the M5Stack Atom's **`GPIO32` (Yellow)** Grove wire, and clamp its `5V` (Red) and `GND` (Black) wires into **`WAGO-3 (+5V_LED)`** and **`WAGO-4 (GND_LED)`**, then press-fit the **3× brown [`Conduit_Cover_Strip`](../output/Conduit_Cover_Strip.stl)** copies (`Conduit_Cover_Strip_01..03` on Plate 2, `11.2 × 68.0 × 2.6 mm` with outer depth-stop flange and `9.80 mm` snap-fit retention rails) flush into the rear channel of `trunk_base`, `trunk_mid`, and `trunk_top`.
3. Seat [`golden_apple_topper`](../output/golden_apple_topper.stl) (`#4`) onto [`trunk_top`](../output/trunk_top.stl)'s upward **`Ø 59.40 × 4.0 mm` Crown Centering Tenon Collar** (`Z = 450.0..454.0 mm`), which telescopes concentrically inside `golden_apple_topper`'s `Ø 60.00 mm` base socket (`0.30 mm` radial clearance) so the Apple Topper locks positively onto the trunk while the 16 RGB LEDs shine straight up into the hollow `~2.2 mm` crimson apple lantern shell!

## Step 8: Load the 8 Wireless Planet LEDs & Snap-Click the Larger 4-Color Planets `1–8` onto the Track Balconies
1. **Assemble the Magic LED Wand ([`Magic_LED_Wand`](../output/Magic_LED_Wand.stl)):**
   - Take one of the **`Ø 8.0 × 2.0 mm` neodymium trigger magnets** included with the Bambu Lab Magnetic Control Switch Lights and press it into the `Ø 8.30 × 2.20 mm` socket in the center of the wand's golden star tip.
2. **Check the Planet Number (`1`–`8`) & Insert the 8 Magnetic LED Lights (`KA006`):**
   - Each of the 8 Solar System planets is **40–55% larger in diameter** (`2.7×–3.7×` larger volume) with 4 sculpted astronomical colors and an integrated **`Ø 13.6 mm` Orbital Pedestal Foot Collar** (`Z = 0.0..3.2 mm`) that elevates the globe and rings above the track wall and rolling marbles (`0.000 mm³` collision).
   - Turn each planet upside down and look through the **`45°` self-centering entry funnel (`Ø 9.30 → Ø 8.00 mm`)** into its **`Ø 8.00 × 10.00 mm`** bottom bore: the inner ceiling is engraved with its solar-system order number **`1` through `8`** (from **`1` = Mercury** at the top near the Apple Sun down to **`8` = Neptune** at the bottom).
   - Push one **Bambu Lab Single LED Magnetic Control Switch Light (`KA006`)** (`Ø 7.5 × 6.0 mm`, LED dome facing UP into the planet) into the upper chamber (`Z = 3.60..9.60 mm`), covering the internal number and leaving the bottom `3.50 mm` (`Z = 0.00..3.50 mm`, with its internal **`Ø 8.44 mm` snap-click detent groove**) open as the mounting socket.
3. **Snap-Click Planet `1–8` onto Balcony Peg `1–8` (Self-Centering Lead-In + Tactile Click):**
   - Each of the 8 outer-rim track balcony pegs (`Ø 7.60 × 3.50 mm`, seated on a `Ø 14.4 mm` landing pad) has a `0.85 mm` conical lead-in tip, an annular **`Ø 8.12 mm` snap-retention bead**, and the matching number **`1` through `8`** engraved on its flat top surface. Simply press each planet onto its matching numbered peg until it clicks into place (hiding the peg number inside the planet bore!):
     - **`1` — Mercury** ([`planet_mercury`](../output/planet_mercury.stl), `Ø 23.3 mm`, Plate 17) → Balcony Peg **`1`** on `track_seg_14_top_entry` (`1590°`)
     - **`2` — Venus** ([`planet_venus`](../output/planet_venus.stl), `Ø 26.5 mm`, Plate 17) → Balcony Peg **`2`** on `track_seg_12` (`1380°`)
     - **`3` — Earth** ([`planet_earth`](../output/planet_earth.stl), `Ø 28.6 mm`, Plate 18) → Balcony Peg **`3`** on `track_seg_10` (`1140°`)
     - **`4` — Mars** ([`planet_mars`](../output/planet_mars.stl), `Ø 28.2 mm`, Plate 17) → Balcony Peg **`4`** on `track_seg_08` (`900°`)
     - **`5` — Jupiter** ([`planet_jupiter`](../output/planet_jupiter.stl), `Ø 36.1 mm`, Plate 17) → Balcony Peg **`5`** on `track_seg_06` (`660°`)
     - **`6` — Saturn** ([`planet_saturn`](../output/planet_saturn.stl), `Ø 44.0 mm` ring span, Plate 17) → Balcony Peg **`6`** on `track_seg_05` (`540°`)
     - **`7` — Uranus** ([`planet_uranus`](../output/planet_uranus.stl), `Ø 36.4 mm` ring span, Plate 18) → Balcony Peg **`7`** on `track_seg_03` (`300°`)
     - **`8` — Neptune** ([`planet_neptune`](../output/planet_neptune.stl), `Ø 29.0 mm`, Plate 18) → Balcony Peg **`8`** on `track_seg_01` (`60°`)

## Step 9: Plug In the Single 12V DC Power Cable, Control in Home Assistant & Tap with the Magic Wand!
1. Tap the 6 crimson apple marbles with the star tip of your **Magic LED Wand** to switch their internal **`KC013` Y-Shape 3-LEDs** **ON** (`Steady Glow`, `Breathe Pulse`, or `Strobe Flash`), then place them onto the helical track—they will glow 100% of the way up the trunk auger (shining through the gothic-arched viewing windows) and all the way down the 4.5-turn spiral track!
2. Plug your **Single External `12V DC` Power Adapter (`5.5 × 2.1 mm` plug)** into the rear `-X` DC barrel jack (`J1`) at the base of `trunk_base`—this single cord powers the `A092` motor driver, the `C008` ESP32 controller, the N20 auger motor, and the dedicated `5V` buck converter feeding all 66 addressable RGB LEDs (zero USB-C cables required during normal operation!). Control the auger speed `0–100%`, reverse anti-jam, and 17 addressable RGBIC lighting scenes directly from **Home Assistant** or by pressing the Atom's built-in button (`GPIO39`) through the `Ø 5.0 mm` hole in `Battery_Cover`.
3. Touch the star tip of your **Magic LED Wand** against any of the **8 planets** or **6 rolling marbles** to cycle its internal wireless LED through **ON (Steady Glow) → Breathe Pulse → Strobe Flash → OFF**, and store the wand upright in the **built-in Root-Flare Wand Holster Socket** on `trunk_base` (`+X/+Y` root at `30°`) when not in use!
