ignacio82/grav-mass/docs/PRINTING.md

# 🖨️ 3D Printing & Support Guide (18 Pre-Arranged `.3mf` Build Plates — Snapmaker U1 `0.4 mm` Nozzle, Zero Collisions, Max 4 Colors Per Plate)

All ready-to-print `.3mf` files are located in [`output/3mf/`](../output/3mf/), pre-configured for the **Snapmaker U1 with a `0.4 mm` nozzle** (`printer_settings_id = "Snapmaker U1 (0.4 nozzle)"`, `nozzle_diameter = ["0.4", "0.4", "0.4", "0.4"]`, `0.20 mm` standard layer height), and use Snapmaker OrcaSlicer's native `5 × 4` multi-plate grid (`324.0 mm` X/Y plate stride centered at `+135.0 mm`) with unified multi-part objects (`<components>` + `<part subtype="normal_part">`). **Every plate contains only the needed parts (including multiple copies of parts used multiple times, such as 3× `Conduit_Cover_Strip`, 24× `bracket_01..24`, and 12× `apple_hemisphere_a/b_01..06`), uses at most 4 colors (4 toolheads), fits comfortably inside a `231 × 231 mm` centered zone (`>= 19.6 mm` bed margin on all 4 sides), has zero 2D Convex-Hull / AABB overlaps (`>= 12.5 mm` part clearance), and Plates 1–15 are 100% single-color plates with `enable_prime_tower = 0`!**

- **All-in-One 18-Plate Project File:** [`output/3mf/GravMass_Tree_Ultimate_U1.3mf`](../output/3mf/GravMass_Tree_Ultimate_U1.3mf)
- **Full 3D Reference Assembly:** [`output/3mf/GravMass_Tree_Complete_Assembly.3mf`](../output/3mf/GravMass_Tree_Complete_Assembly.3mf)
- **Required Filament Spools & Palettes:** See **[`docs/BOM.md` — Section 3 (3D Printing Filament)](BOM.md#3-3d-printing-filament-snapmaker-u1-4-toolhead-palettes--max-4-colors-per-plate)**

## Plate-by-Plate Breakdown & Support Settings

| Plate | `.3mf` File | Toolhead(s) & Palette (`<= 4` Colors) | Color Mode | Supports Needed? | Recommended OrcaSlicer Settings | Parts on Plate |
| :---: | :--- | :---: | :---: | :---: | :--- | :--- |
| **Plate 1** | [`Plate_1_SingleColor_Brown_Trunk_Base.3mf`](../output/3mf/Plate_1_SingleColor_Brown_Trunk_Base.3mf) | **`T1` Only** (`#4A2F1D` Brown PLA) | **Single-Color** *(0 swaps, 0 prime tower)* | **No (`100% Support-Free`)** | `0.20 mm` layer, 3 walls, 15% Gyroid, **Supports: OFF** | `trunk_base` (`#1`), `Base_Bottom_Cover` (2 objects, `204.9 × 144.5 mm`, `15.1 mm` gap) |
| **Plate 2** | [`Plate_2_SingleColor_Brown_Trunk_Upper_And_Covers.3mf`](../output/3mf/Plate_2_SingleColor_Brown_Trunk_Upper_And_Covers.3mf) | **`T1` Only** (`#4A2F1D` Brown PLA) | **Single-Color** *(0 swaps, 0 prime tower)* | **No (`100% Support-Free`)** | `0.20 mm` layer, 3 walls, 15% Gyroid, **Supports: OFF** | `trunk_mid` (`#2`), `trunk_top` (`#3`), `Battery_Cover`, `3× Conduit_Cover_Strip` (`_01..03` for the 3 trunk sections), `Servo_Or_030_Adapter` (7 objects, `16.2 mm` gap) |
| **Plate 3** | [`Plate_3_SingleColor_Brown_Brackets_01_To_12.3mf`](../output/3mf/Plate_3_SingleColor_Brown_Brackets_01_To_12.3mf) | **`T1` Only** (`#4A2F1D` Brown PLA) | **Single-Color** *(0 swaps, 0 prime tower)* | **No (`100% Support-Free`)** | `0.20 mm` layer, 3 walls, 15% Gyroid, **Supports: OFF** *(upright on flat `Z = 0` lower rib)* | `bracket_01` through `bracket_12` (12 exact-radius station brackets, `14.6 mm` gap) |
| **Plate 4** | [`Plate_4_SingleColor_Brown_Brackets_13_To_24.3mf`](../output/3mf/Plate_4_SingleColor_Brown_Brackets_13_To_24.3mf) | **`T1` Only** (`#4A2F1D` Brown PLA) | **Single-Color** *(0 swaps, 0 prime tower)* | **No (`100% Support-Free`)** | `0.20 mm` layer, 3 walls, 15% Gyroid, **Supports: OFF** *(upright on flat `Z = 0` lower rib)* | `bracket_13` through `bracket_24` (12 exact-radius station brackets, `14.6 mm` gap) |
| **Plate 5** | [`Plate_5_SingleColor_Green_Track_01.3mf`](../output/3mf/Plate_5_SingleColor_Green_Track_01.3mf) | **`T2` Only** (`#00A86B` Green PETG) | **Single-Color** *(0 swaps, 0 prime tower)* | **Minimal (`~2–5 mm` under mid-arch)** | `0.20 mm` layer, 3 walls, 15% Gyroid, **Supports: ON (`Tree (auto)` + `On build plate only` + `Don't support bridges`)** | Dedicated solo `track_seg_01` (`230.8 × 230.1 × 47.8 mm`, `Z_min = 0.000 mm`, `>= 19.6 mm` margin to all 4 bed edges) |
| **Plate 6** | [`Plate_6_SingleColor_Green_Track_02.3mf`](../output/3mf/Plate_6_SingleColor_Green_Track_02.3mf) | **`T2` Only** (`#00A86B` Green PETG) | **Single-Color** *(0 swaps, 0 prime tower)* | **Minimal (`~2–5 mm` under mid-arch)** | `0.20 mm` layer, 3 walls, 15% Gyroid, **Supports: ON (`Tree (auto)` + `On build plate only` + `Don't support bridges`)** | Dedicated solo `track_seg_02` (`203.4 × 202.2 × 32.7 mm`) |
| **Plate 7** | [`Plate_7_SingleColor_Green_Track_03.3mf`](../output/3mf/Plate_7_SingleColor_Green_Track_03.3mf) | **`T2` Only** (`#00A86B` Green PETG) | **Single-Color** *(0 swaps, 0 prime tower)* | **Minimal (`~2–5 mm` under mid-arch)** | `0.20 mm` layer, 3 walls, 15% Gyroid, **Supports: ON (`Tree (auto)` + `On build plate only` + `Don't support bridges`)** | Dedicated solo `track_seg_03` (`195.6 × 194.4 × 34.9 mm`) |
| **Plate 8** | [`Plate_8_SingleColor_Green_Track_04.3mf`](../output/3mf/Plate_8_SingleColor_Green_Track_04.3mf) | **`T2` Only** (`#00A86B` Green PETG) | **Single-Color** *(0 swaps, 0 prime tower)* | **Minimal (`~2–5 mm` under mid-arch)** | `0.20 mm` layer, 3 walls, 15% Gyroid, **Supports: ON (`Tree (auto)` + `On build plate only` + `Don't support bridges`)** | Dedicated solo `track_seg_04` (`187.8 × 186.6 × 33.4 mm`) |
| **Plate 9** | [`Plate_9_SingleColor_Green_Track_05_And_13.3mf`](../output/3mf/Plate_9_SingleColor_Green_Track_05_And_13.3mf) | **`T2` Only** (`#00A86B` Green PETG) | **Single-Color** *(0 swaps, 0 prime tower)* | **Minimal (`~2–5 mm` under mid-arch)** | `0.20 mm` layer, 3 walls, 15% Gyroid, **Supports: ON (`Tree (auto)` + `On build plate only` + `Don't support bridges`)** | Side-by-side `track_seg_05` + `track_seg_13` (2 objects, zero convex-hull overlap) |
| **Plate 10** | [`Plate_10_SingleColor_Green_Track_06_And_12.3mf`](../output/3mf/Plate_10_SingleColor_Green_Track_06_And_12.3mf) | **`T2` Only** (`#00A86B` Green PETG) | **Single-Color** *(0 swaps, 0 prime tower)* | **Minimal (`~2–5 mm` under mid-arch)** | `0.20 mm` layer, 3 walls, 15% Gyroid, **Supports: ON (`Tree (auto)` + `On build plate only` + `Don't support bridges`)** | Side-by-side `track_seg_06` + `track_seg_12` (2 objects, zero convex-hull overlap) |
| **Plate 11** | [`Plate_11_SingleColor_Green_Track_07_And_11.3mf`](../output/3mf/Plate_11_SingleColor_Green_Track_07_And_11.3mf) | **`T2` Only** (`#00A86B` Green PETG) | **Single-Color** *(0 swaps, 0 prime tower)* | **Minimal (`~2–5 mm` under mid-arch)** | `0.20 mm` layer, 3 walls, 15% Gyroid, **Supports: ON (`Tree (auto)` + `On build plate only` + `Don't support bridges`)** | Side-by-side `track_seg_07` + `track_seg_11` (2 objects, zero convex-hull overlap) |
| **Plate 12** | [`Plate_12_SingleColor_Green_Track_08_And_10.3mf`](../output/3mf/Plate_12_SingleColor_Green_Track_08_And_10.3mf) | **`T2` Only** (`#00A86B` Green PETG) | **Single-Color** *(0 swaps, 0 prime tower)* | **Minimal (`~2–5 mm` under mid-arch)** | `0.20 mm` layer, 3 walls, 15% Gyroid, **Supports: ON (`Tree (auto)` + `On build plate only` + `Don't support bridges`)** | Side-by-side `track_seg_08` + `track_seg_10` (2 objects, zero convex-hull overlap) |
| **Plate 13** | [`Plate_13_SingleColor_Green_Track_09_And_14.3mf`](../output/3mf/Plate_13_SingleColor_Green_Track_09_And_14.3mf) | **`T2` Only** (`#00A86B` Green PETG) | **Single-Color** *(0 swaps, 0 prime tower)* | **Minimal (`~2–5 mm` under mid-arch)** | `0.20 mm` layer, 3 walls, 15% Gyroid, **Supports: ON (`Tree (auto)` + `On build plate only` + `Don't support bridges`)** | Side-by-side `track_seg_09` + `track_seg_14_top_entry` (2 objects, zero convex-hull overlap) |
| **Plate 14** | [`Plate_14_SingleColor_Gold_Auger_And_Drive.3mf`](../output/3mf/Plate_14_SingleColor_Gold_Auger_And_Drive.3mf) | **`T3` Only** (`#D4AF37` Silk Gold PLA) | **Single-Color** *(0 swaps, 0 prime tower)* | **No (`100% Support-Free`)** | `0.20 mm` layer, 3 walls, 15% Gyroid, **Supports: OFF** | `auger_lower`, `auger_upper`, `Motor_Clutch_Driver` (3 objects, `22.0 mm` gap) |
| **Plate 15** | [`Plate_15_SingleColor_Red_Apple_Marbles.3mf`](../output/3mf/Plate_15_SingleColor_Red_Apple_Marbles.3mf) | **`T4` Only** (`#C41E3A` Red PLA) | **Single-Color** *(0 swaps, 0 prime tower)* | **No (`100% Support-Free`)** | `0.16–0.20 mm` layer, **2 walls**, 10% Gyroid, **Supports: OFF** | `6× Apple_Hemisphere_A` (`_01..06`) + `6× Apple_Hemisphere_B` (`_01..06`) = 6 complete twist-lock marbles (12 objects, `16.0 mm` gap) |
| **Plate 16** | [`Plate_16_MultiColor_Topper_And_Wand.3mf`](../output/3mf/Plate_16_MultiColor_Topper_And_Wand.3mf) | **4 Colors (Tree Palette):** `T1 #4A2F1D` Brown, `T2 #00A86B` Green, `T3 #D4AF37` Gold, `T4 #C41E3A` Red | **4-Color** *(Unified Objects)* | **Minimal** *(under Apple Leaf)* | `0.16–0.20 mm` layer, **2 walls**, 10% Gyroid, **Supports: ON (`Tree (auto)` + `On build plate only`)** | `golden_apple_topper` (unified Red Shell + Brown Stem + Green Leaf + Trunk Collar), `Magic_LED_Wand` (2 unified objects, `25.0 mm` gap) |
| **Plate 17** | [`Plate_17_MultiColor_Planets_Warm_And_Gas_Giants.3mf`](../output/3mf/Plate_17_MultiColor_Planets_Warm_And_Gas_Giants.3mf) | **4 Colors (Warm Palette):** `T1 #4A2F1D` Umber, `T2 #F5EFE6` Alabaster White, `T3 #D4AF37` Gold, `T4 #C41E3A` Crimson | **4-Color** *(Unified Objects)* | **Minimal** *(under Saturn ring)* | `0.16 mm` layer, **2 walls**, 12% Gyroid, **Supports: ON (`Tree (auto)` + `On build plate only`)** *(45° Orbital Pedestal Foot Collar makes globes self-supporting!)* | **5 Larger 4-Color Sculpted Planets:** `planet_mercury` (`Ø 23.3 mm`), `planet_venus` (`Ø 26.5 mm`), `planet_mars` (`Ø 28.2 mm`), `planet_jupiter` (`Ø 36.1 mm`), `planet_saturn` (`Ø 44.0 mm` ring span) |
| **Plate 18** | [`Plate_18_MultiColor_Planets_Ocean_And_Ice_Giants.3mf`](../output/3mf/Plate_18_MultiColor_Planets_Ocean_And_Ice_Giants.3mf) | **4 Colors (Ocean/Ice Palette):** `T1 #1E5AA8` Cobalt Blue, `T2 #00A86B` Emerald/Teal, `T3 #F0F4F8` Ice White, `T4 #D4AF37` Gold | **4-Color** *(Unified Objects)* | **Minimal** *(under Uranus tilted ring)* | `0.16 mm` layer, **2 walls**, 12% Gyroid, **Supports: ON (`Tree (auto)` + `On build plate only`)** | **3 Larger 4-Color Sculpted Planets:** `planet_earth` (`Ø 28.6 mm`), `planet_uranus` (`Ø 36.4 mm` ring span), `planet_neptune` (`Ø 29.0 mm`) |

> **💡 Pitch-Leveled Horizontal Track Orientation (`Option A`) + `"On build plate only"`:**  
> Every helical track segment (`track_seg_01`..`14`) is **pitch-tilted by its helical chord angle (`~6.4°–12.9°`)** so **both its downhill end and uphill end rest flat on the build plate (`Z = 0.0`)**—dropping segment print height from `55.3 mm` down to `~35.0 mm` and cutting mid-span support height by **`> 70%`** (to just a shallow `~2–5 mm` arch in the middle) while running filament extrusions smoothly along the marble rolling path! Enabling **"On build plate only"** and **"Don't support bridges"** keeps the `45°` underside LED dovetail channel, snap-lock sockets, and bracket peg holes 100% clean and free of support material.
