ignacio82/grav-mass/(commit log)

2026-11-08 Initial commit: Grav-Mass Day Marble Run Tree (12V Single-Cable Solder-Free Edition, CC BY-NC 4.0 + MIT)
    [Apple_Hemisphere_A.step, Apple_Hemisphere_A.stl, Apple_Hemisphere_B.step, Apple_Hemisphere_B.stl, Base_Bottom_Cover.step, Base_Bottom_Cover.stl, Battery_Cover.step, Battery_Cover.stl]
2026-11-08 Fix gh-pages deployment (.nojekyll + output tree) and stabilize bottom marble queue & LEDs
    [grav-mass-tree.yaml]
2026-11-08 Add machine-readable BOM (bom/bom.yaml) and generator (scripts/gen_bom.py)
    [bom.csv]
2026-11-08 Split printing, assembly, physics, smart-home, and development guides into docs/
2026-11-08 Add docs/REFACTOR_NOTES.md and BOM sync check GitHub workflow
2026-11-08 fix(docs,bom): resolve all 8 review items and update verified electronic component dimensions
    [bom.csv]
2026-11-08 feat(cad,webapp): add dedicated UCTRONICS buck and WAGO 221-415 snap-in cradles to trunk_base
    [Apple_Hemisphere_A.step, Apple_Hemisphere_B.step, Base_Bottom_Cover.step, Battery_Cover.step, Conduit_Cover_Strip.step, GravMass_Tree_Complete_Assembly.3mf, GravMass_Tree_Ultimate_U1.3mf, Magic_LED_Wand.step]
