ignacio82/grav-mass/(notices)

Notices in the files:
README.md:
License: CC BY-NC 4.0 (3D Model & CAD)
License: MIT (Web App & ESPHome)
